makers-upv/maker-xmas-tree/wled/README.md

<!-- FLASH WLED -->
## Flashing custom WLED firmware

### Prerequisites (Windows)

First you will need to install Python and esptool to flash the custom WLED firmware into the ESP8266
* python
https://www.python.org/downloads/windows/

* esptool
  ```sh
  pip install esptool
  ```
### Installation

1. Execute ```flash_wled.bat``` and the procedure will start

<!-- USAGE EXAMPLES -->
## Changin presets and recompiling littlefs image

TODO
