makers-upv/maker-xmas-tree/presentation/Taller Introducción Soldadura.pdf

# Taller

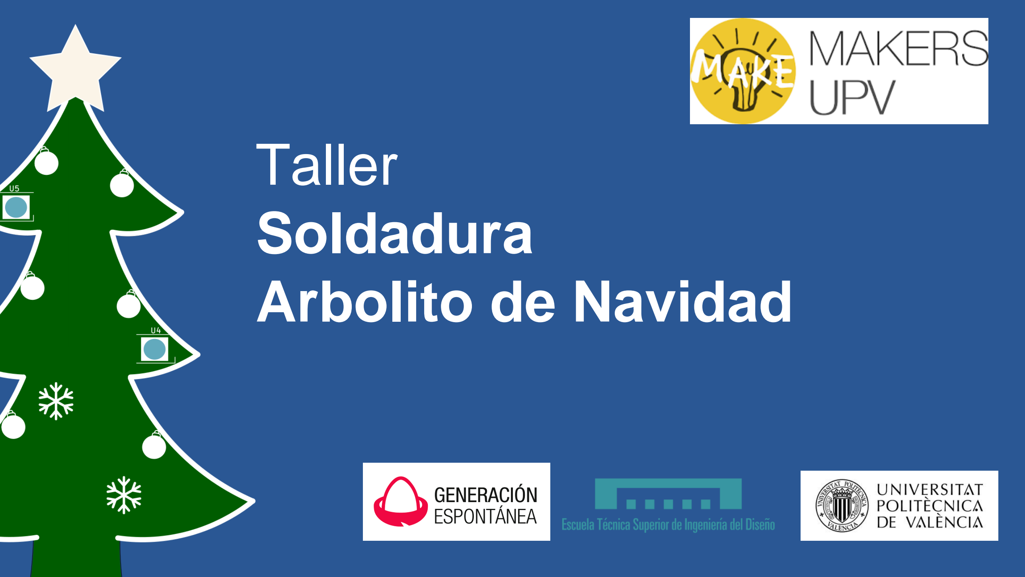
[picture p1: page 1]

# Soldadura Arbolito de Navidad

Taller
Soldadura Arbolito de Navidad

### Agenda

1. ¿Qué es una PCB?
2. Tipos de componentes
3. ¿Qué es soldar?
4. Cómo soldar
5. Soldadura SMD
6. Formas de soldar

Soldadura Arbolito de Navidad

### ¿Qué es una PCB?

PCB ("printed circuit board" en inglés) o placa de circuito impreso en español. Es básicamente es un soporte físico en donde se instalan componentes electrónicos y eléctricos y se interconectan entre ellos.

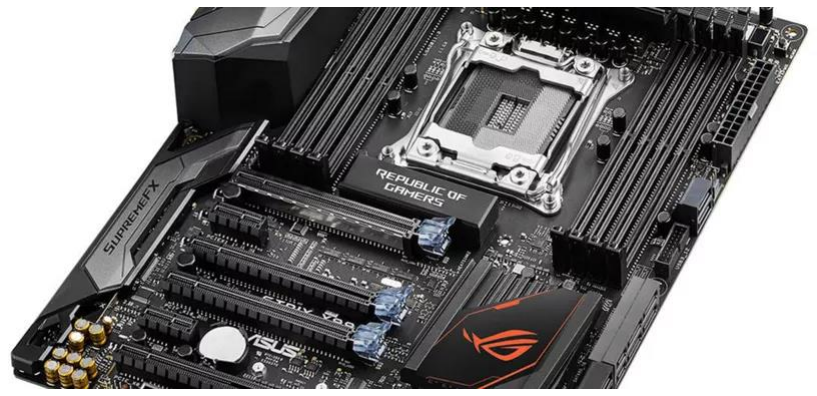
[picture p2: figure]
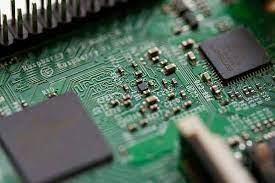
[picture p3: figure]

### Tipos de componentes

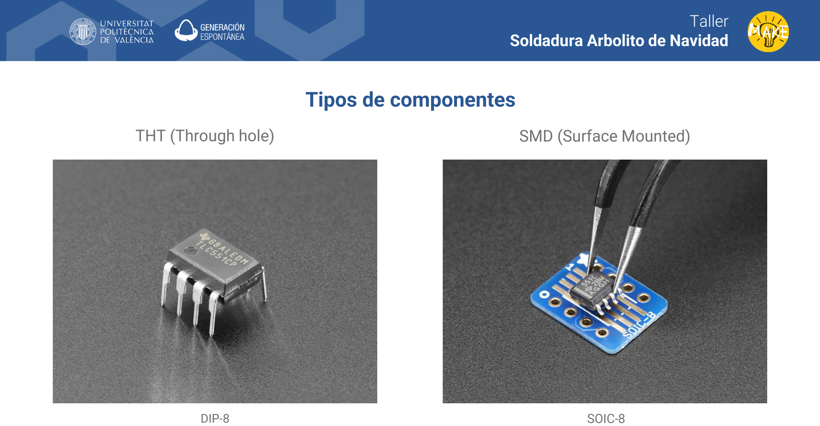
[picture p4: page 4]

Soldadura Arbolito de Navidad

THT (Through hole) | SMD (Surface Mounted)
DIP-8 | SOIC-8

### Tipos de componentes

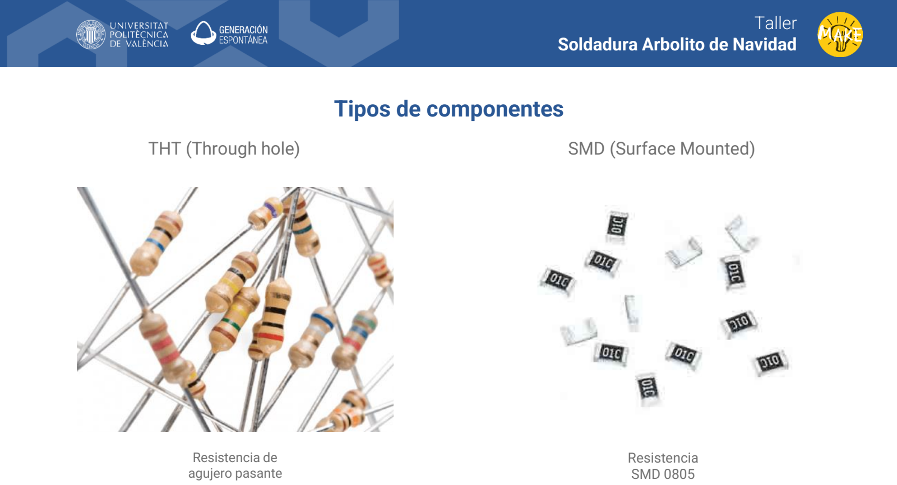
[picture p5: page 5]

Soldadura Arbolito de Navidad

THT (Through hole) | SMD (Surface Mounted)

Resistencia de
agujero pasante

Resistencia
SMD 0805

### Resistencias vs condensadores SMD

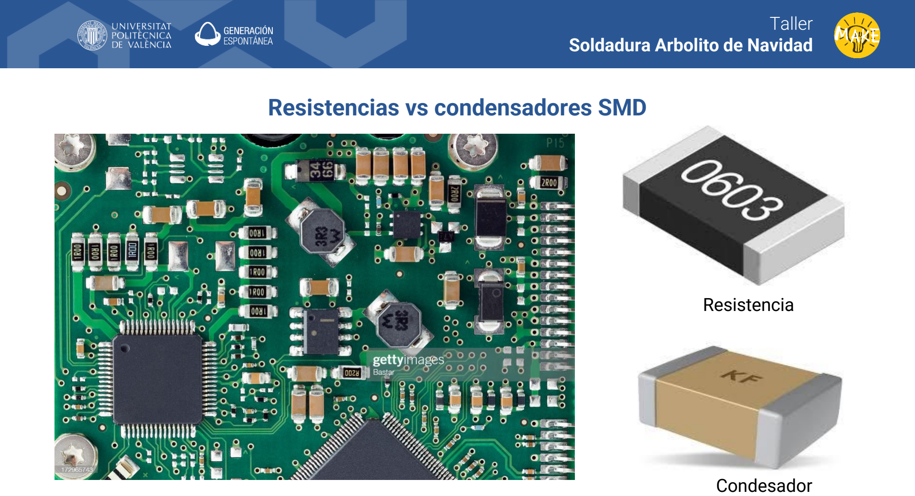
[picture p6: page 6]

Soldadura Arbolito de Navidad

Condesador

Resistencia

Soldadura Arbolito de Navidad

### Encapsulados típicos

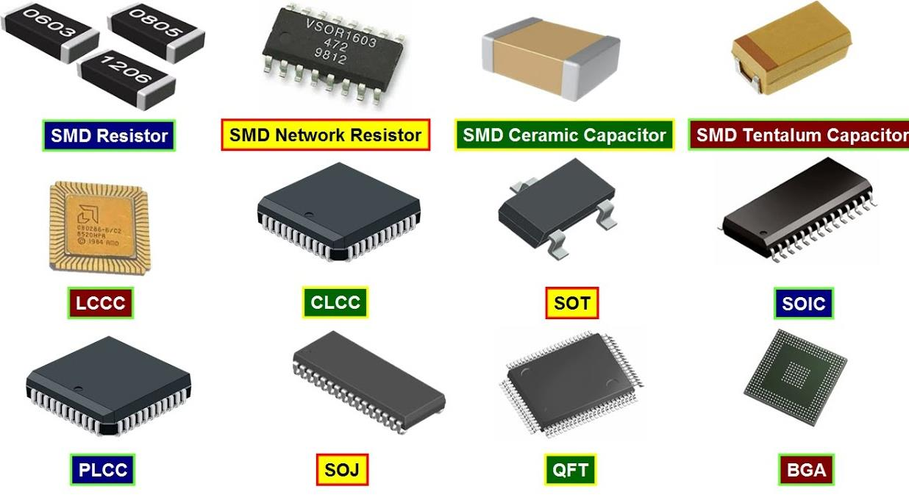
[picture p7: figure]

Soldadura Arbolito de Navidad

### ¿Que es soldar?

Consiste en unir los componentes tanto de forma electrica como mecánica usando un metal con temperatura de fusión baja (180 a 260)ºC. Normalemente (aka siempre) estaño.

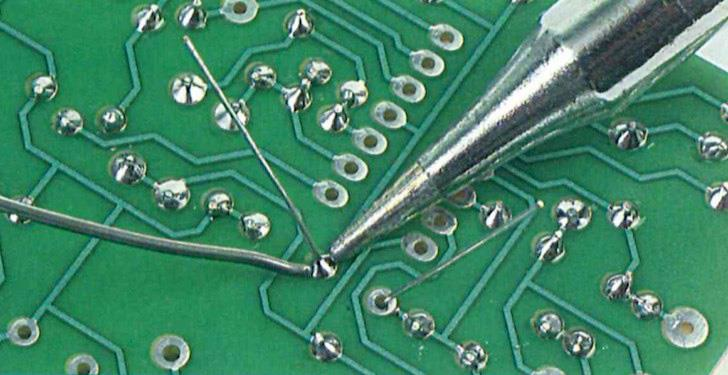
[picture p8: figure]

### Tipos de estaño

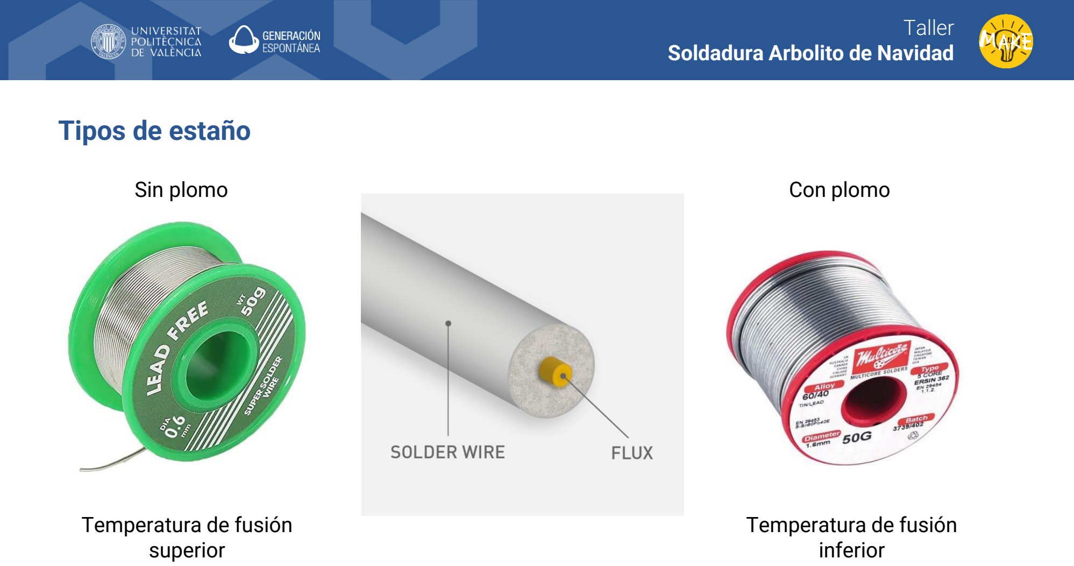
[picture p9: page 9]

Soldadura Arbolito de Navidad

Sin plomo | Con plomo

Temperatura de fusión
superior

Temperatura de fusión
inferior

Soldadura Arbolito de Navidad

### Flux

El flux es un fundente que elimina las películas de óxido que se forman en la superficie de los metales que se están soldando. Además hace que el esaño fluya de manera más uniforme sobre las superficies sin formar bolas.
Existe en formato líquido, formato pasta, formato boli…

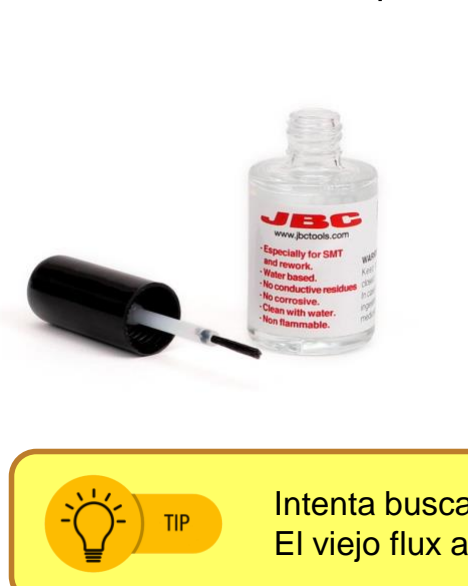
[picture p10: figure]
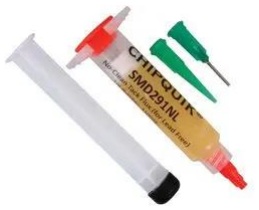
[picture p11: figure]

Intenta buscar “No-clean Flux”

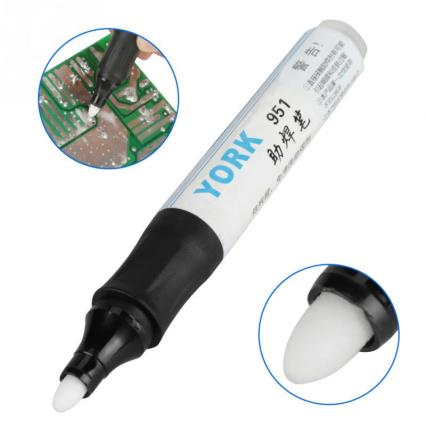
[picture p12: figure]

El viejo flux a base de resina de colofonia es muy sucio y tóxico. No usar flux de fontanero!

Soldadura Arbolito de Navidad

### Soldador formato lapiz

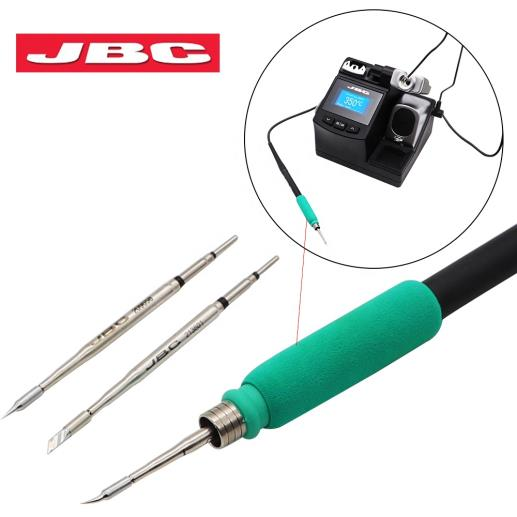
[picture p13: figure]
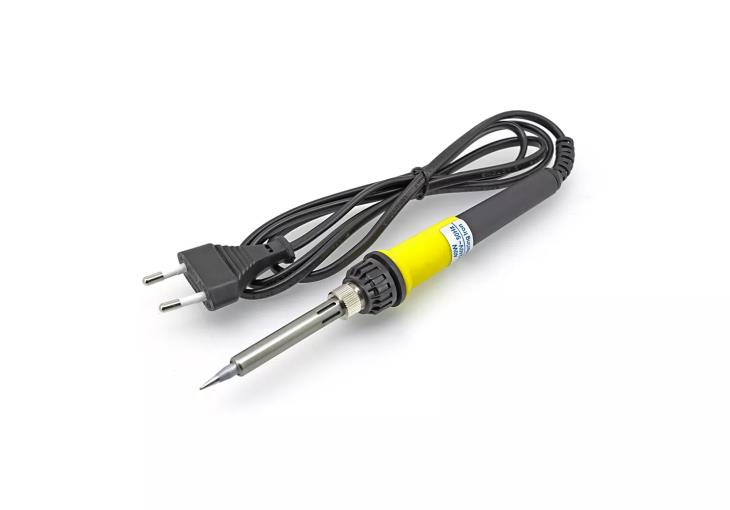
[picture p14: figure]

Un buen soldador no es un gasto, es una inversión!
Es como un cuchillo a un chef, merece la pena gastarse un poco más. Se nota!!

Hay dos tipos, los de teconología antigua (de cartucho) y los modernos que permiten cambiar las puntas en caliente.

### Soldadura THT/PTH

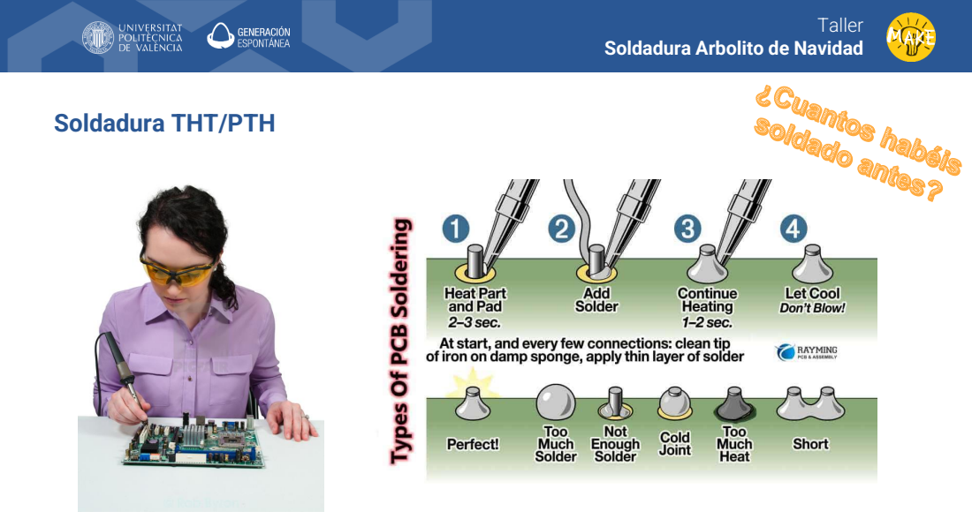
[picture p15: page 12]

Soldadura Arbolito de Navidad

### La soldadura perfecta

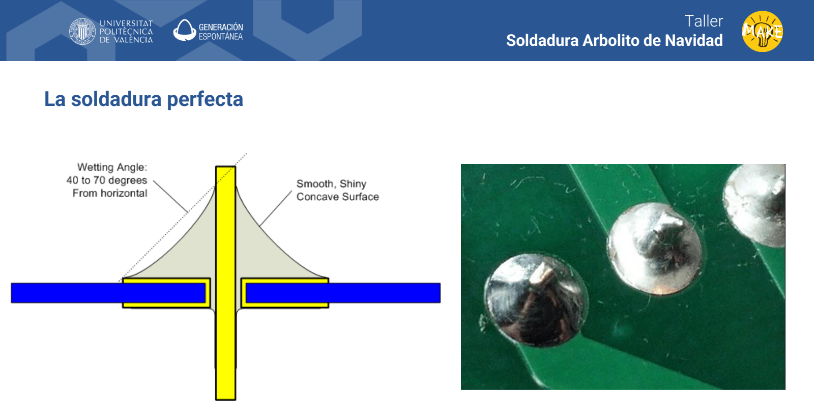
[picture p16: page 13]

Soldadura Arbolito de Navidad

Soldadura Arbolito de Navidad

### Ejemplos no tan buenos … I

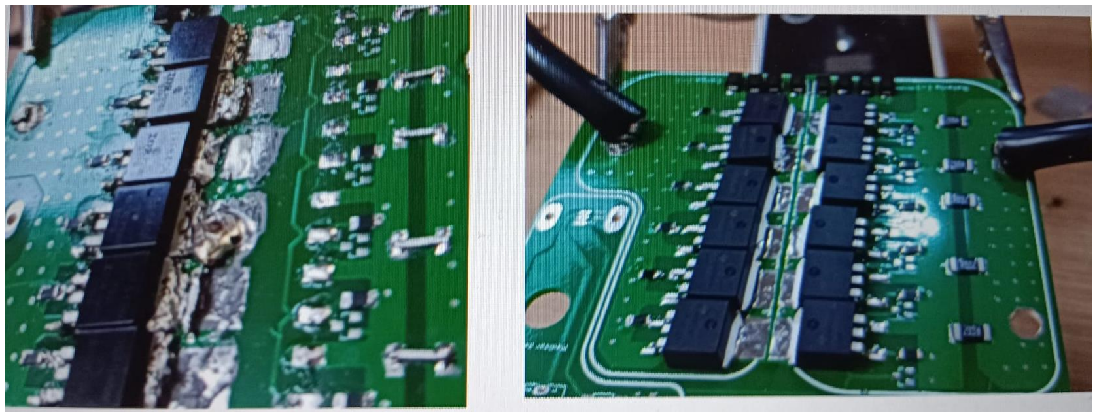
[picture p17: figure]

No pasa nada si al prinicipio sueldas como el de la izquierda. La práctica hace al maestro.

Soldadura Arbolito de Navidad

### Ejemplos II

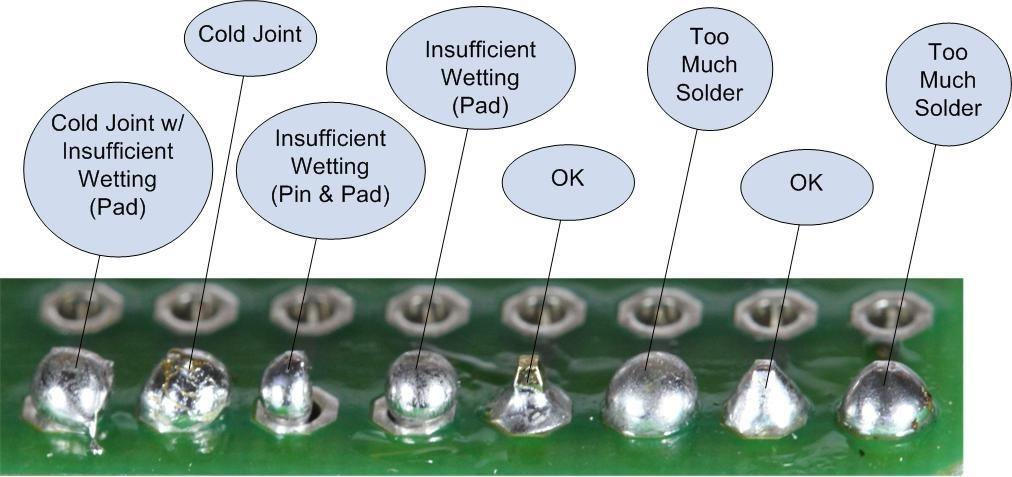
[picture p18: figure]

Puedes usar flux para mejorar la soldadura. Pero no te emociones... ☺

### Soldadura SMD

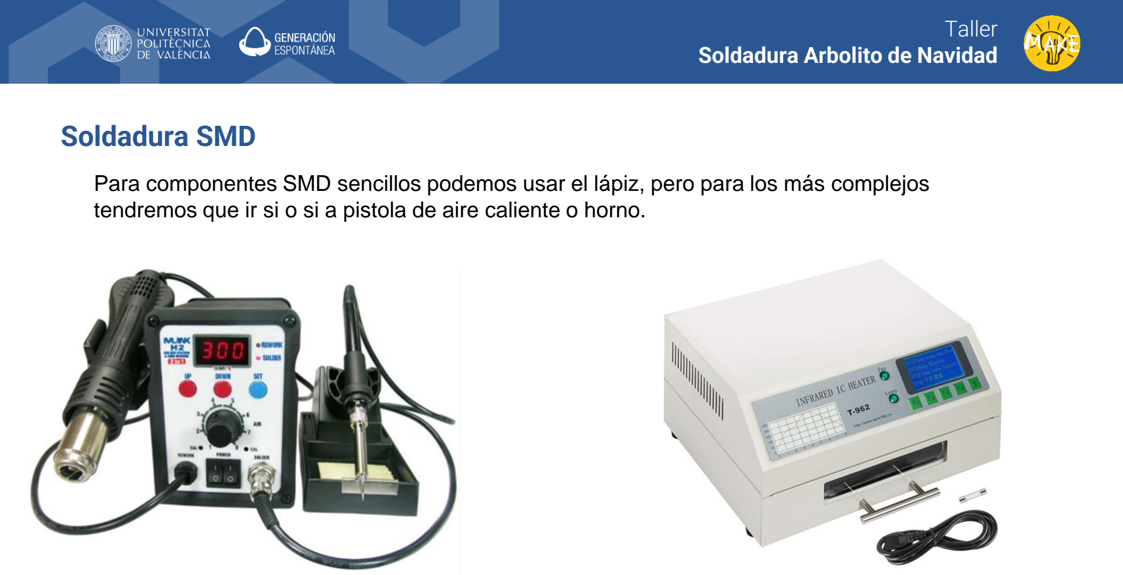
[picture p19: page 16]

Soldadura Arbolito de Navidad

Para componentes SMD sencillos podemos usar el lápiz, pero para los más complejos tendremos que ir si o si a pistola de aire caliente o horno.

### Resistencias y condensadores SMD

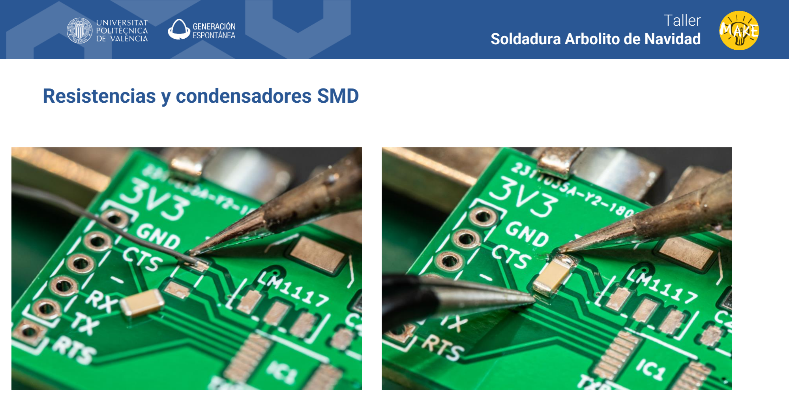
[picture p20: page 17]

Soldadura Arbolito de Navidad

### Estaño en pasta

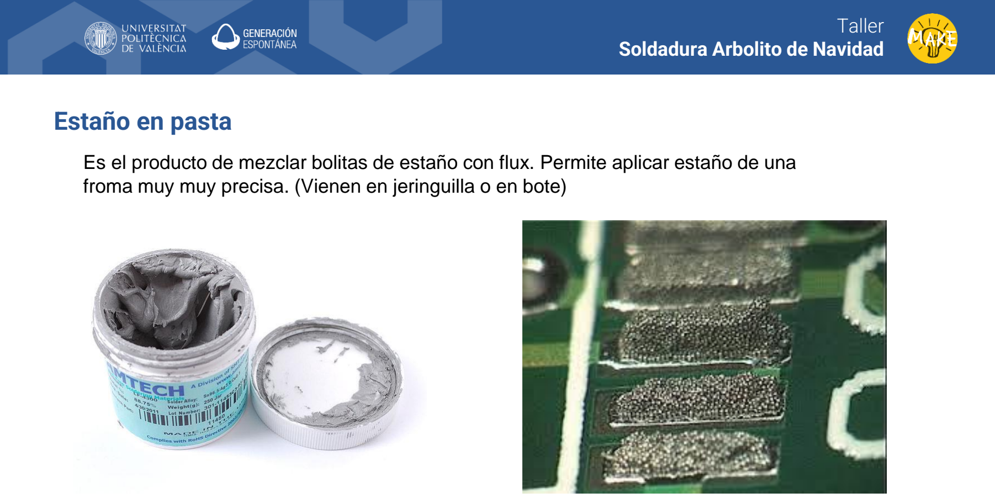
[picture p21: page 18]

Soldadura Arbolito de Navidad

Es el producto de mezclar bolitas de estaño con flux. Permite aplicar estaño de una froma muy muy precisa. (Vienen en jeringuilla o en bote)

### Stencil

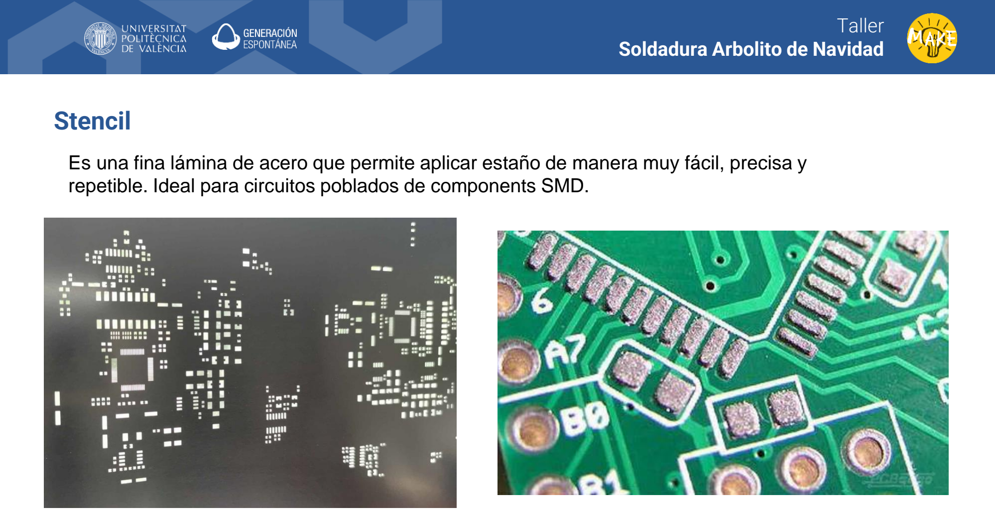
[picture p22: page 19]

Soldadura Arbolito de Navidad

Es una fina lámina de acero que permite aplicar estaño de manera muy fácil, precisa y repetible. Ideal para circuitos poblados de components SMD.

Soldadura Arbolito de Navidad

### Poner pasta con stencil

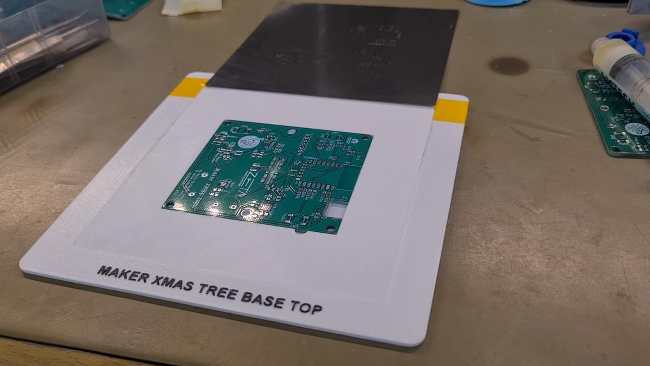
[picture p23: figure]

Soldadura Arbolito de Navidad

### Posicionar componentes

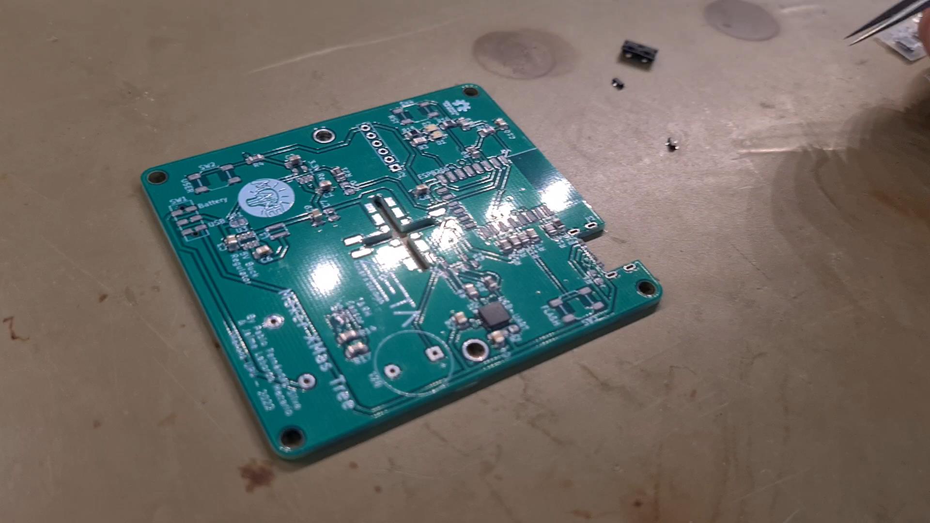
[picture p24: figure]

Soldadura Arbolito de Navidad

### ¿Como sabemos donde va cada cosa?

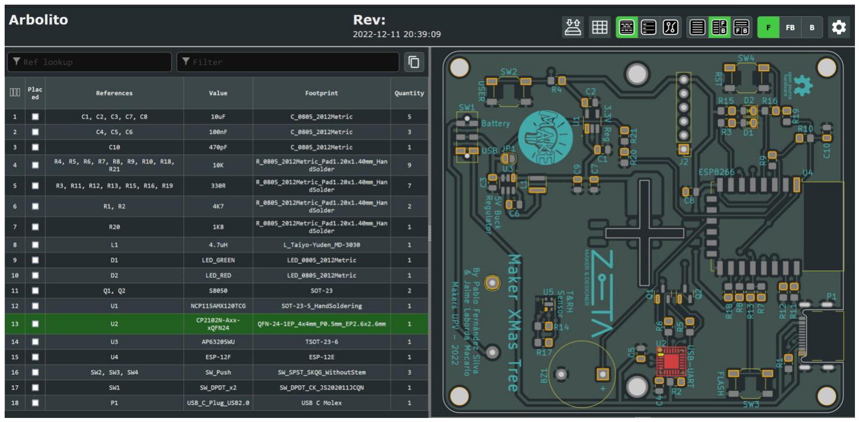
[picture p25: figure]

makers-upv.github.io/maker-xmas-tree

Soldadura Arbolito de Navidad

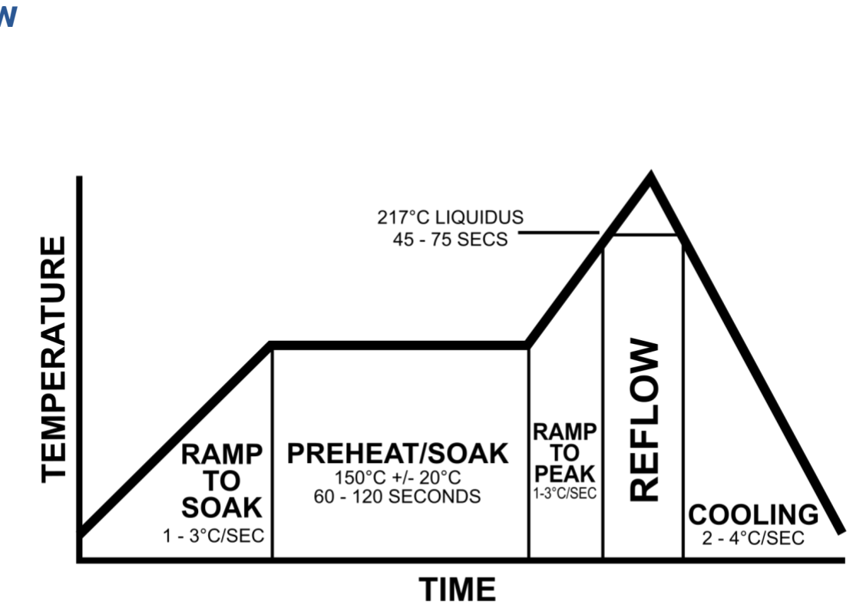
[picture p26: figure]

### Horno reflow

### Soldar portabaterías

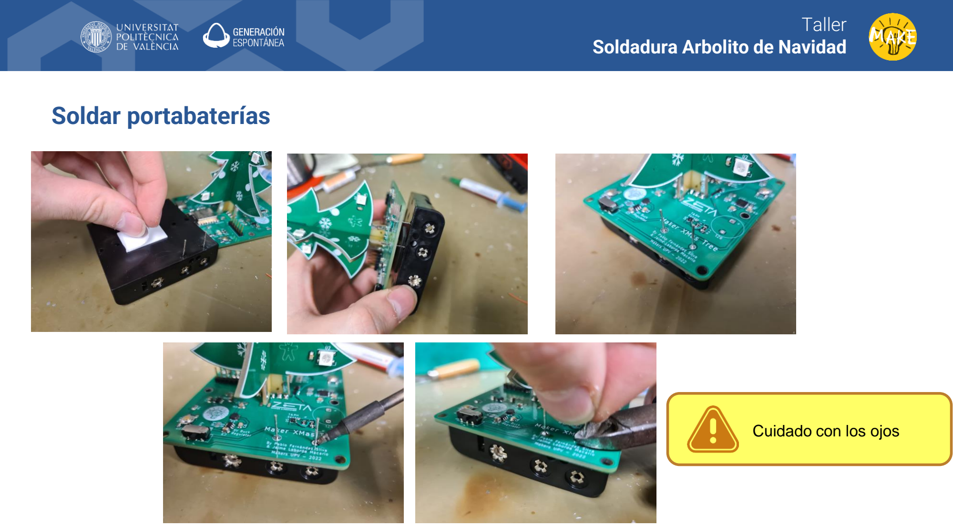
[picture p27: page 24]

Soldadura Arbolito de Navidad

Cuidado con los ojos

Manos a la obra..

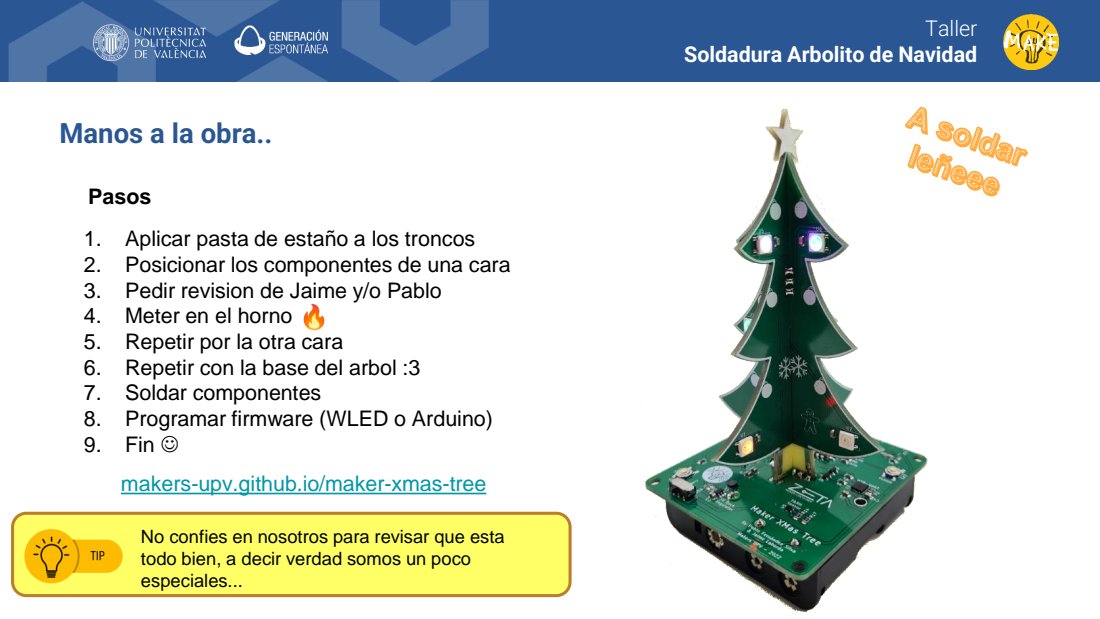
[picture p28: page 25]
Pasos

Soldadura Arbolito de Navidad

1. Aplicar pasta de estaño a los troncos
2. Posicionar los componentes de una cara
3. Pedir revision de Jaime y/o Pablo
4. Meter en el horno
5. Repetir por la otra cara
6. Repetir con la base del arbol :3
7. Soldar componentes
8. Programar firmware (WLED o Arduino)
9. Fin ☺

makers-upv.github.io/maker-xmas-tree

No confies en nosotros para revisar que esta
todo bien, a decir verdad somos un poco
especiales...

Soldadura Arbolito de Navidad

# Instalar firmware WLED

### Instalar firmware WLED

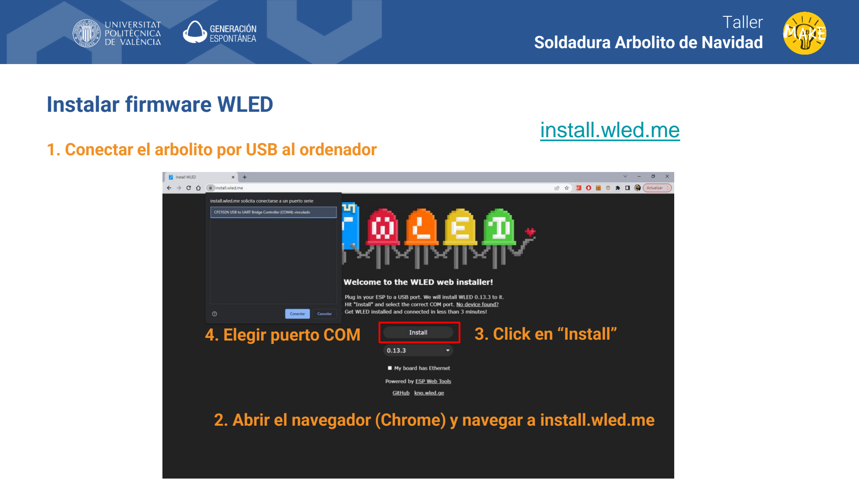
[picture p29: page 27]

Soldadura Arbolito de Navidad

### 1. Conectar el arbolito por USB al ordenador

### 2. Abrir el navegador (Chrome) y navegar a install.wled.me

4. Elegir puerto COM | 3. Click en “Install”

### install.wled.me

Soldadura Arbolito de Navidad

### Instalar firmware WLED

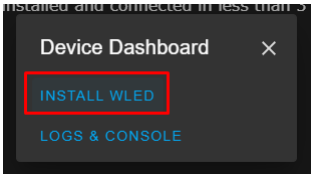
[picture p30: figure]
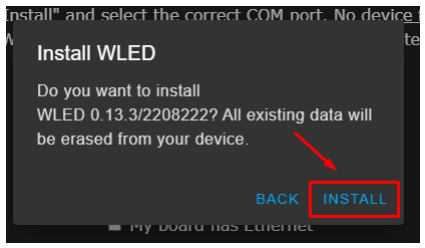
[picture p31: figure]

5. Click en “Install WLED” | 6. Click en “Install”

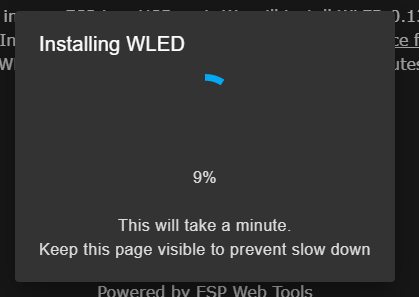
[picture p32: figure]

Instalando…

Soldadura Arbolito de Navidad

### Instalar firmware WLED

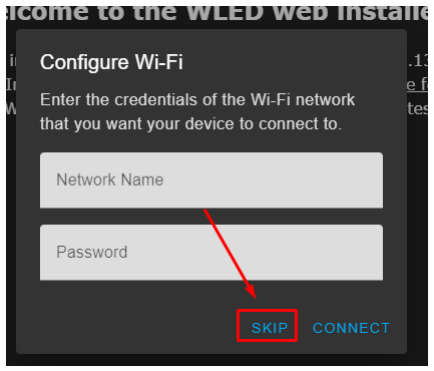
[picture p33: figure]
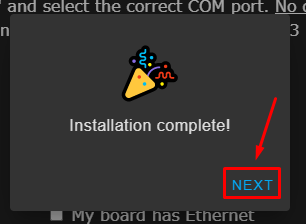
[picture p34: figure]

7. Click en “Skip” | 8. Click en Next

### Configurar WLED desde el móvil (o PC)

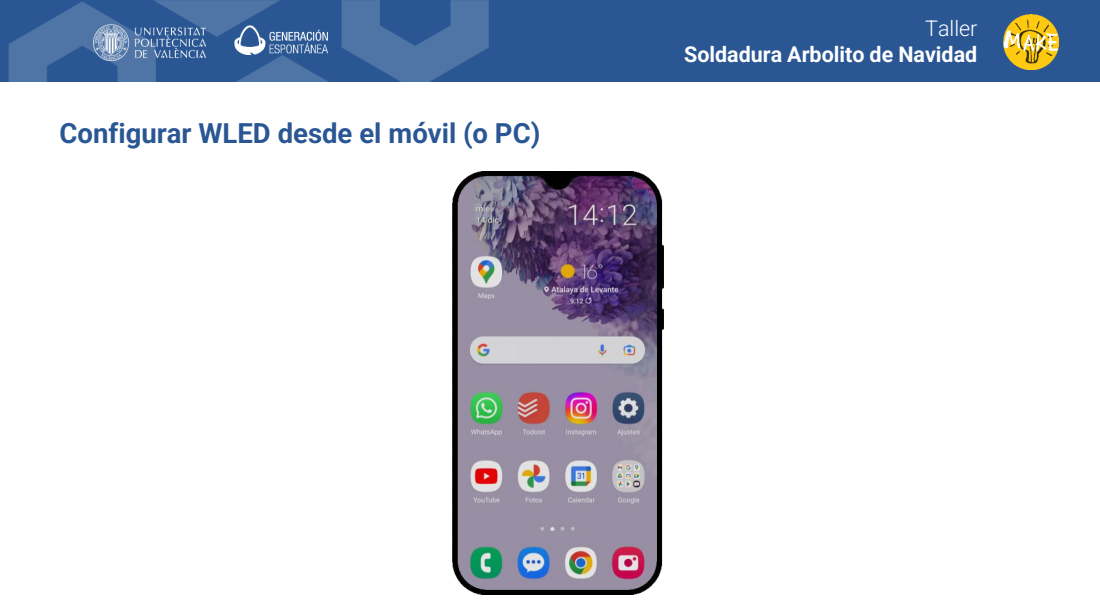
[picture p35: page 30]

Soldadura Arbolito de Navidad

Soldadura Arbolito de Navidad

### Modificar los colores con WLED

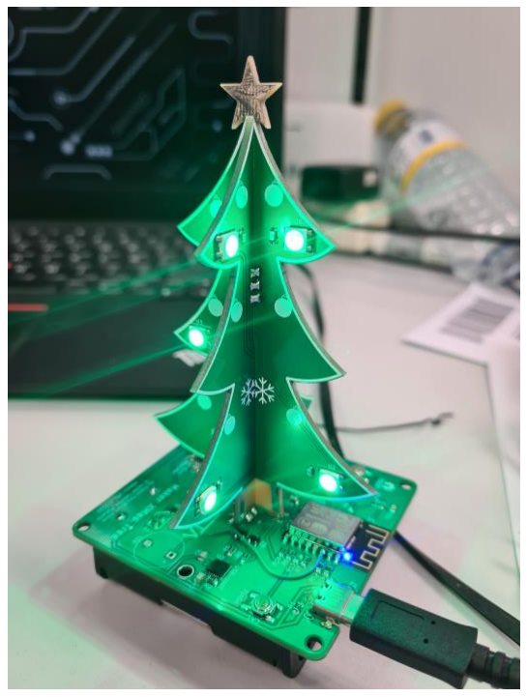
[picture p36: figure]
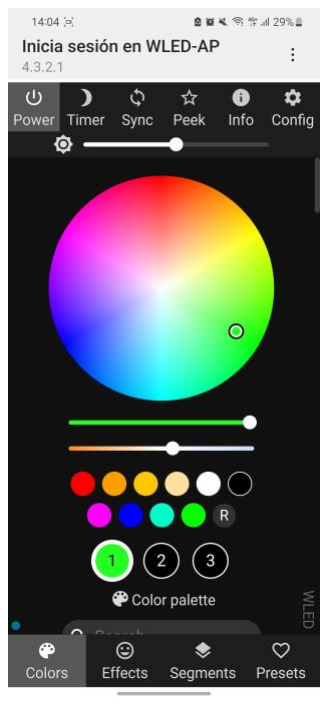
[picture p37: figure]

Soldadura Arbolito de Navidad

# Firmware Arduino Neopixel

Soldadura Arbolito de Navidad

### 1. Instalar Arduino IDE (www.arduino.cc/en/software)

### Firmware Arduino Neopixel

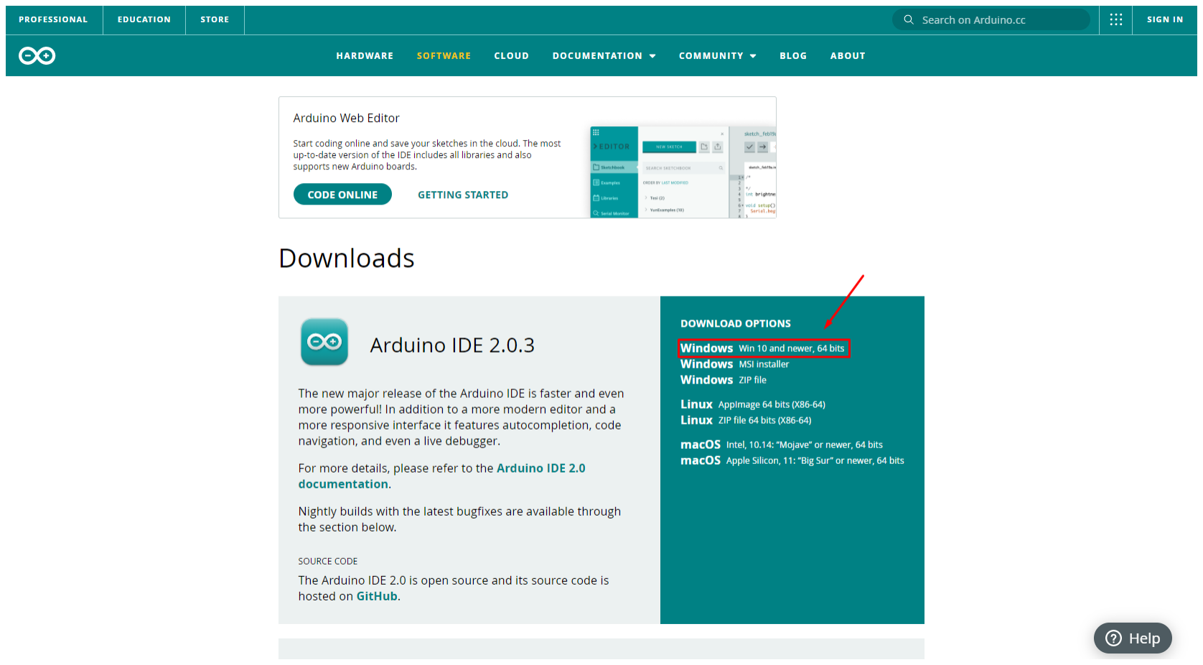
[picture p38: figure]

### Firmware Arduino Neopixel

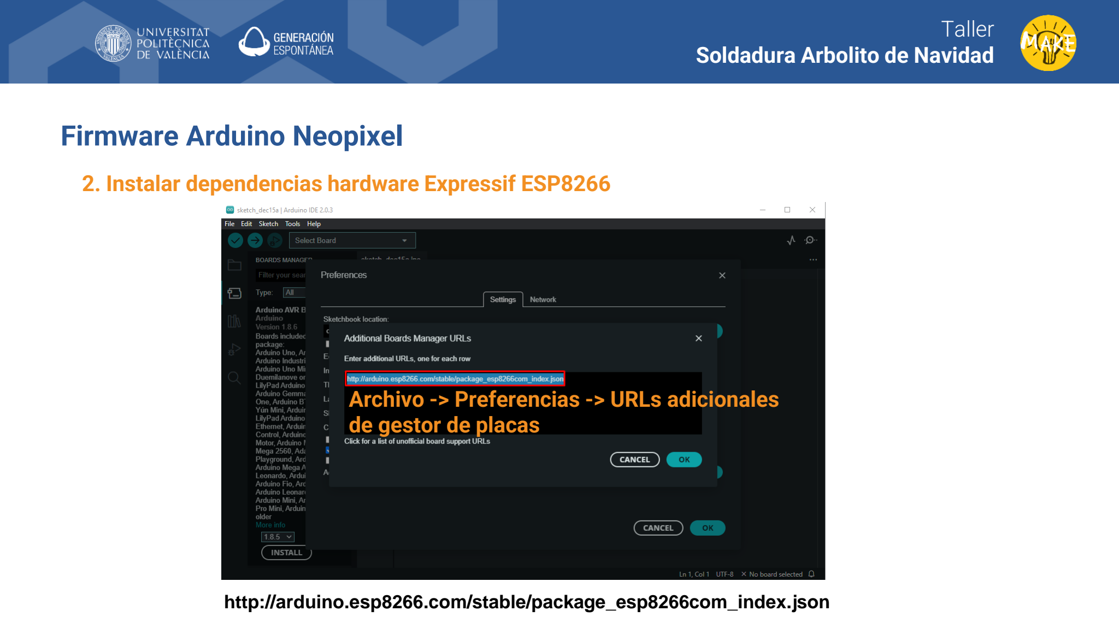
[picture p39: page 34]

Soldadura Arbolito de Navidad

### 2. Instalar dependencias hardware Expressif ESP8266

http://arduino.esp8266.com/stable/package_esp8266com_index.json

Archivo -> Preferencias -> URLs adicionales de gestor de placas

### Firmware Arduino Neopixel

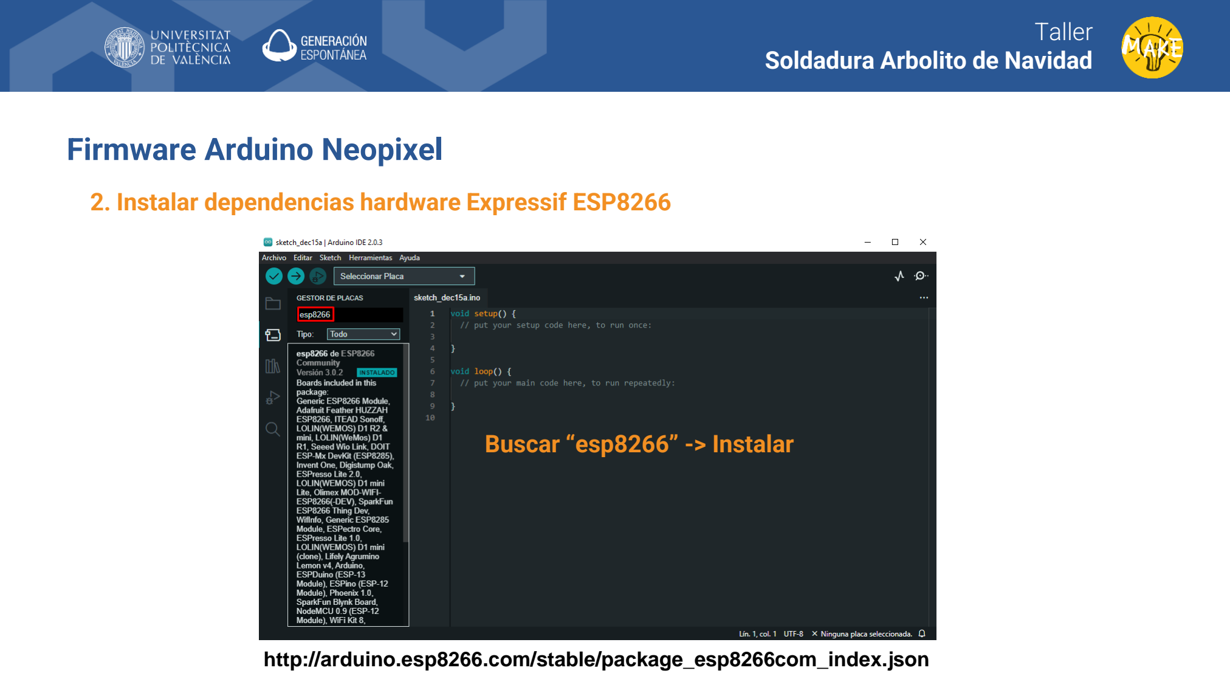
[picture p40: page 35]

Soldadura Arbolito de Navidad

Buscar “esp8266” -> Instalar

### 2. Instalar dependencias hardware Expressif ESP8266

http://arduino.esp8266.com/stable/package_esp8266com_index.json

### Firmware Arduino Neopixel

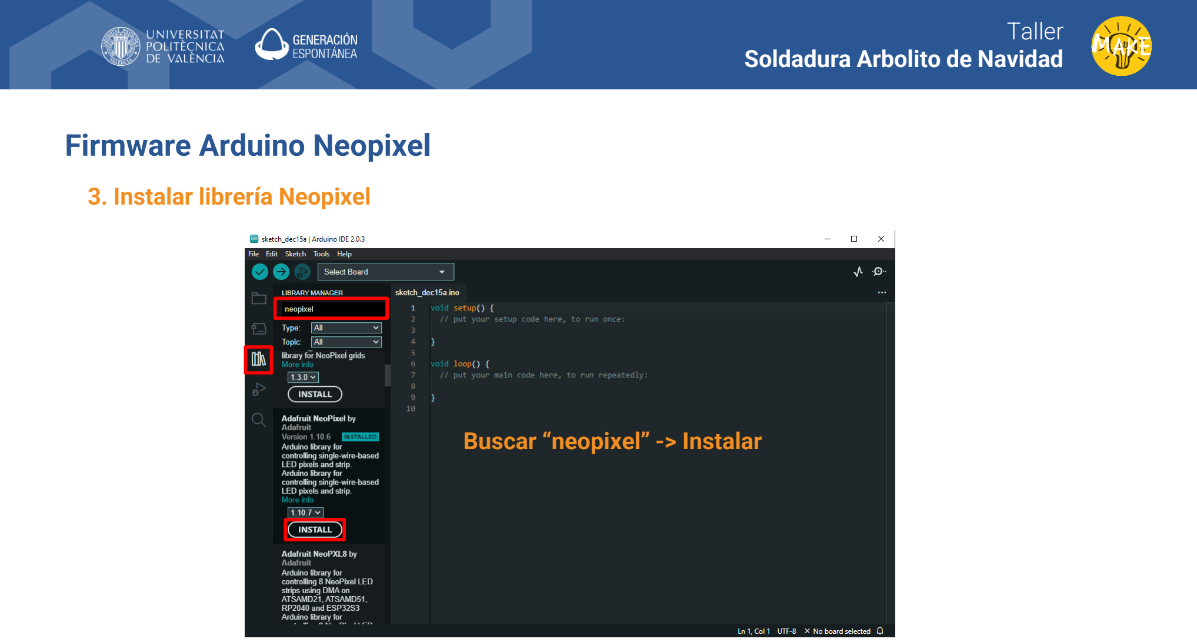
[picture p41: page 36]

Soldadura Arbolito de Navidad

### 3. Instalar librería Neopixel

Buscar “neopixel” -> Instalar

### Firmware Arduino Neopixel

Soldadura Arbolito de Navidad

### 3. Instalar librería Neopixel

Buscar “neopixel” -> Instalar

Soldadura Arbolito de Navidad

### Firmware Arduino Neopixel

### 4. Seleccionar la placa y el puerto COM (Buscar “nodemcu”)

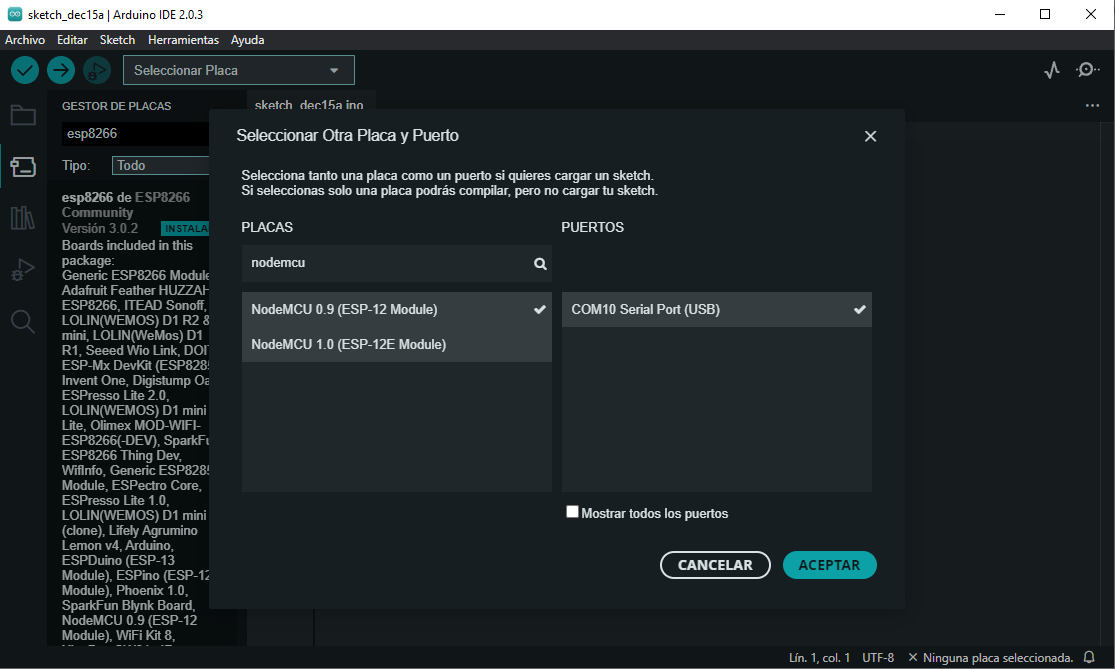
[picture p42: figure]

Soldadura Arbolito de Navidad

### Firmware Arduino Neopixel

### 5. Cargar el ejemplo “Strandtest”

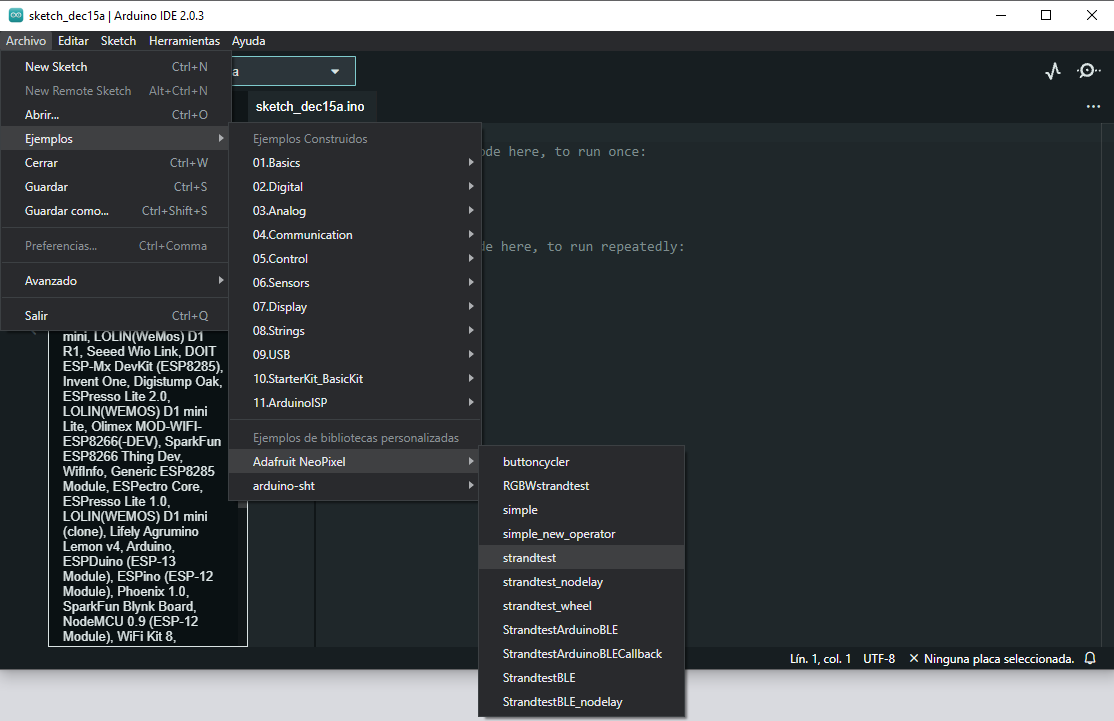
[picture p43: figure]

Soldadura Arbolito de Navidad

### Firmware Arduino Neopixel

### 6. Modificar LED_PIN y LED_COUNT a 12

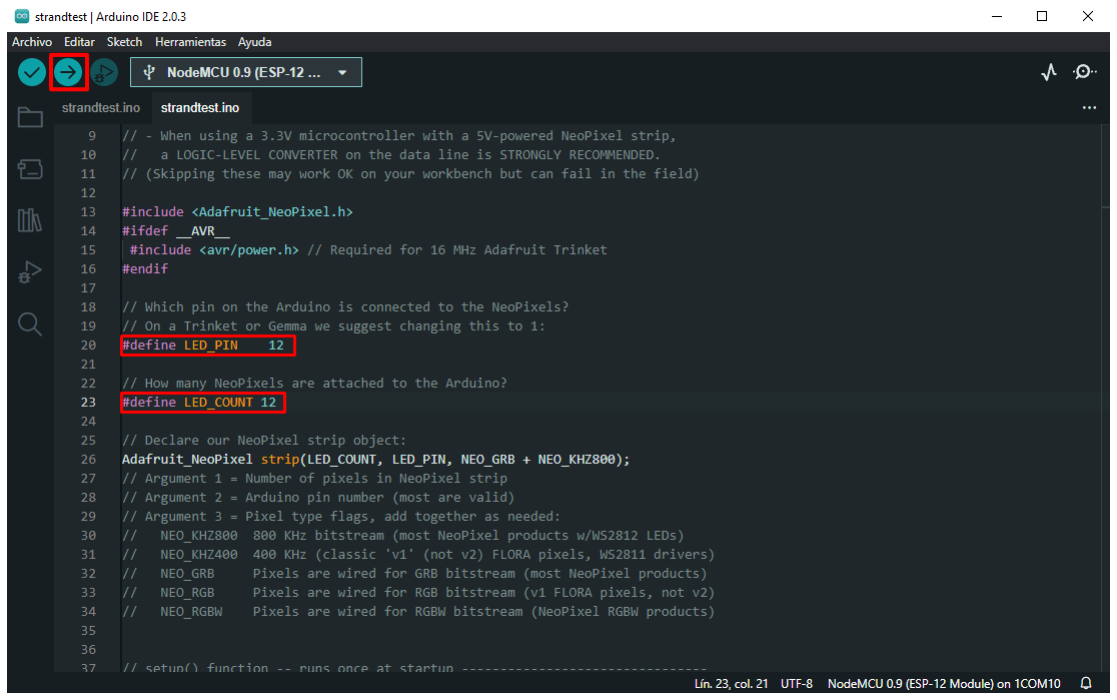
[picture p44: figure]
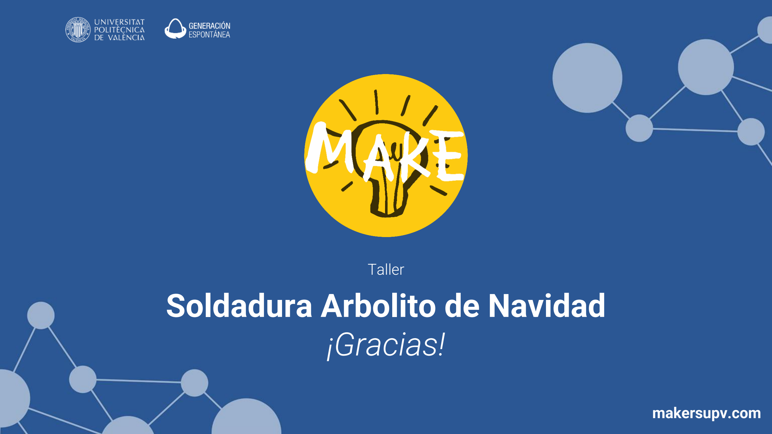
[picture p45: page 41]

Soldadura Arbolito de Navidad

Taller

# Soldadura Arbolito de Navidad ¡Gracias!

makersupv.com
