makers-upv/maker-xmas-tree/pcb/3d/Arbolito Tronco 1.step

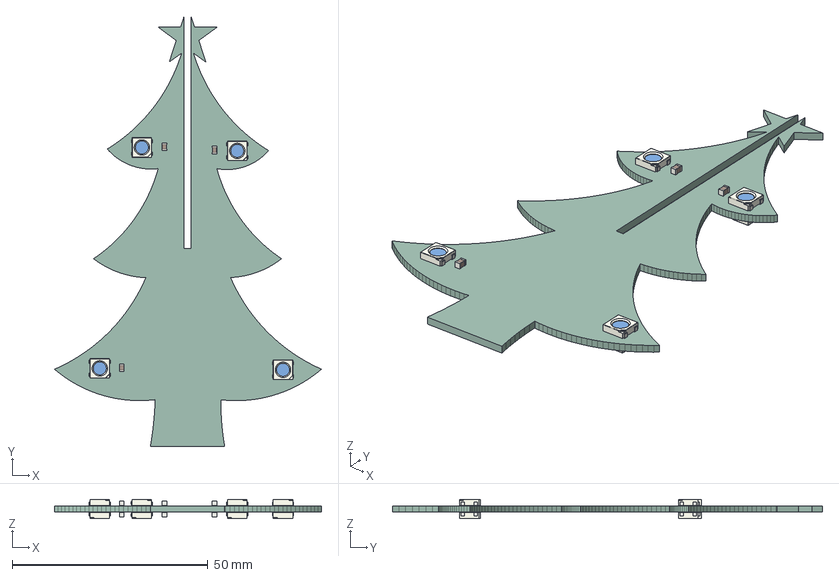
[picture p46: CAD file, 2023-12-17]
pcb/3d/Arbolito Tronco 1.step
68.2 x 109.9 x 4.90 mm
PCB
