makers-upv/maker-xmas-tree/pcb/kicad/Base/Arbolito.dxf

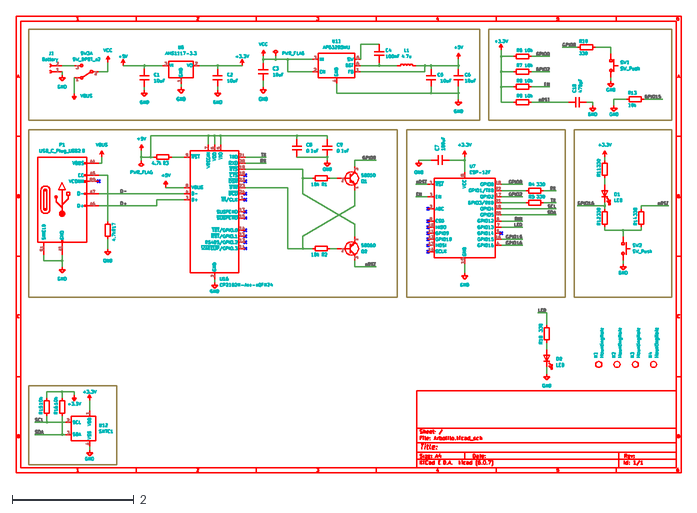
[picture p47: CAD file, 2023-12-17]
pcb/kicad/Base/Arbolito.dxf
10.9 x 7.48
