makers-upv/maker-xmas-tree/tools/Join tool/Maker XMas Tree Joint Tool.STEP

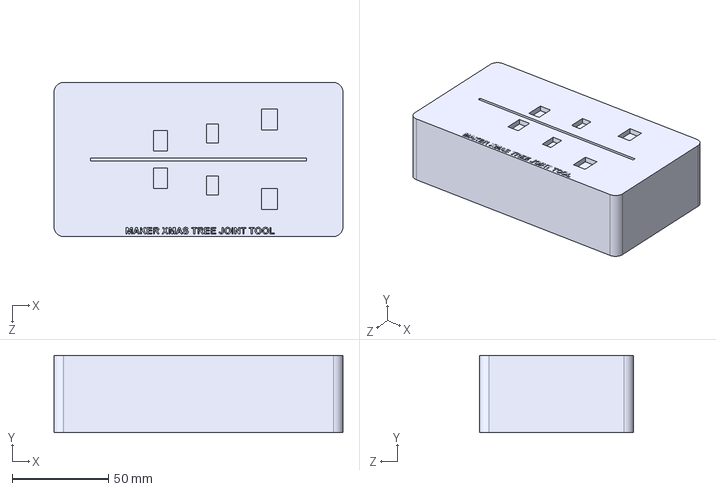
[picture p48: CAD file, 2023-12-17]
tools/Join tool/Maker XMas Tree Joint Tool.STEP
150.0 x 40.2 x 80.0 mm
