makers-upv/maker-xmas-tree/tools/Stencil tool/Stencil tool Maker XMas Tree Arbol rev2.SLDPRT

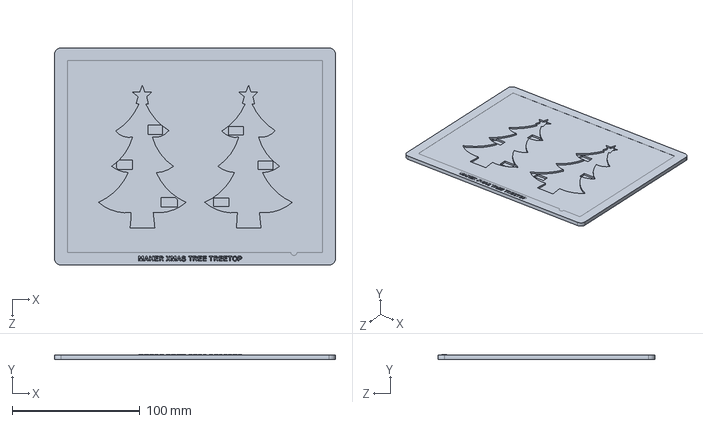
[picture p49: CAD file, 2023-12-17]
tools/Stencil tool/Stencil tool Maker XMas Tree Arbol rev2.SLDPRT
220.0 x 4.15 x 170.0 mm
