makers-upv/maker-xmas-tree/pcb/3d/Arbolito Tronco 2.step

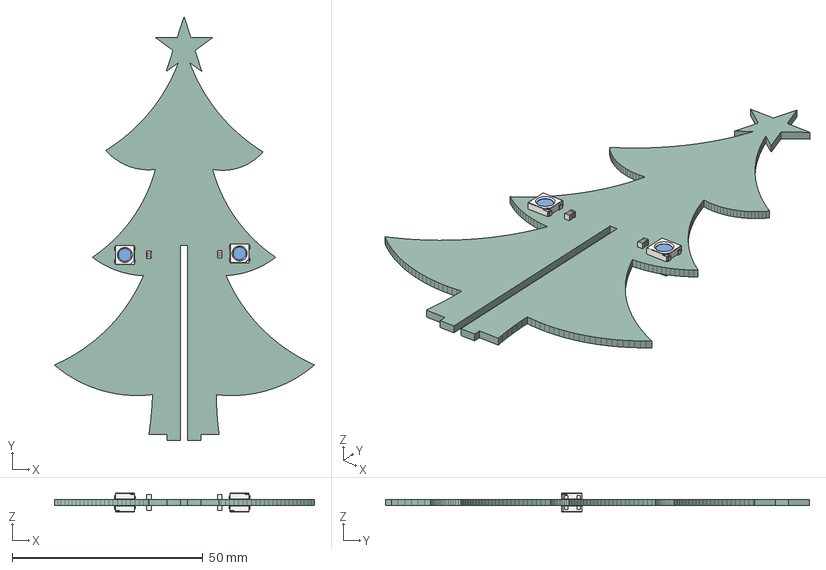
[picture p50: CAD file, 2023-12-17]
pcb/3d/Arbolito Tronco 2.step
68.2 x 111.0 x 4.90 mm
PCB
