makers-upv/maker-xmas-tree/pcb/3d/Arbolito.step

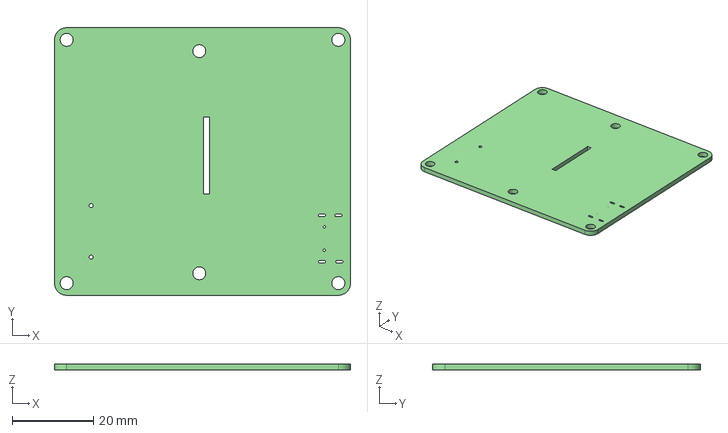
[picture p51: CAD file, 2023-12-17]
pcb/3d/Arbolito.step
73.0 x 66.0 x 1.60 mm
