makers-upv/maker-xmas-tree/tools/Stencil tool/Stencil tool Maker XMas Tree Base v2.SLDPRT

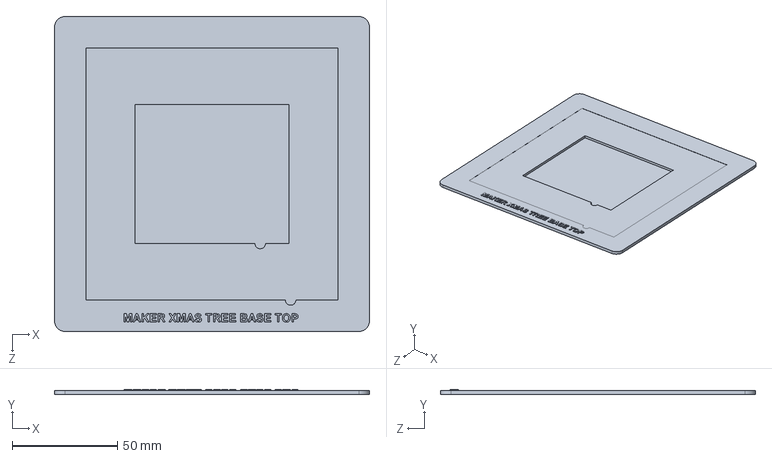
[picture p52: CAD file, 2023-12-17]
tools/Stencil tool/Stencil tool Maker XMas Tree Base v2.SLDPRT
150.0 x 2.35 x 150.0 mm
