makers-upv/maker-xmas-tree/(list of files, cad)

Other CAD files:
tools/Stencil tool/Stencil tool Maker XMas Tree Arbol rev3.STL
tools/Join tool/Maker XMas Tree Joint Tool.SLDPRT
tools/Join tool/Maker XMas Tree Joint Tool.STL
tools/Stencil tool/Stencil tool Maker XMas Tree Base v2.STL
