makers-upv/maker-xmas-tree/(threads)

Thread 2 (2023-12-17):

USB UART Programming not working

jaimelaborda, 2023-12-17:
USB UART Programming not working in Rev3 because D+ & D- lines are twisted (differential pairs do have polarity @Pfersil13)

https://electronics.stackexchange.com/questions/73295/in-a-usb-cable-is-it-ok-to-swap-the-d-and-d-wires
