makers-upv/maker-xmas-tree/pcb/sch/MakersXmasTree_Base.pdf

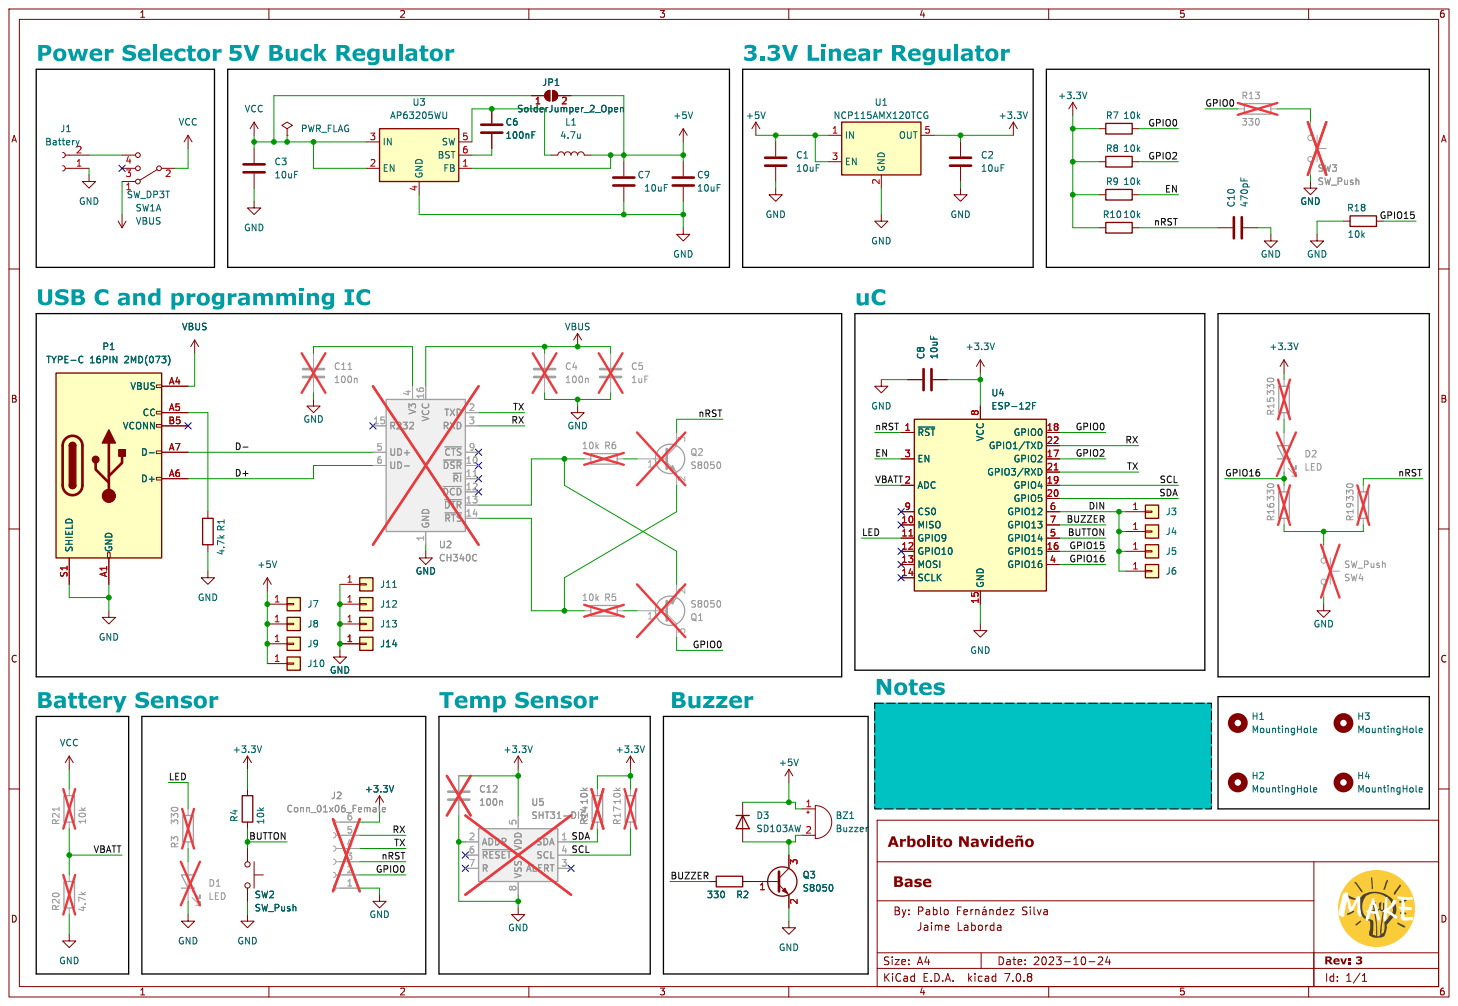
[picture p53: page 1]

4 UD+ 5 UD- 6 ~{CTS}9 P1 TYPE-C 16PIN 2MD(073) GND A1 VBUS A4 CC A5 D+ A6 D- A7 VCONN B5 SHIELD S1 VBUS

1 ~{DSR} 10 ~{RI} 11 ~{DCD} 12 ~{DTR} 13 ~{RTS} 14 R232 15 VCC 16 TXD 2 RXD 3 V3
