makers-upv/maker-xmas-tree/pcb/sch/MakersXmasTree_Top1.pdf

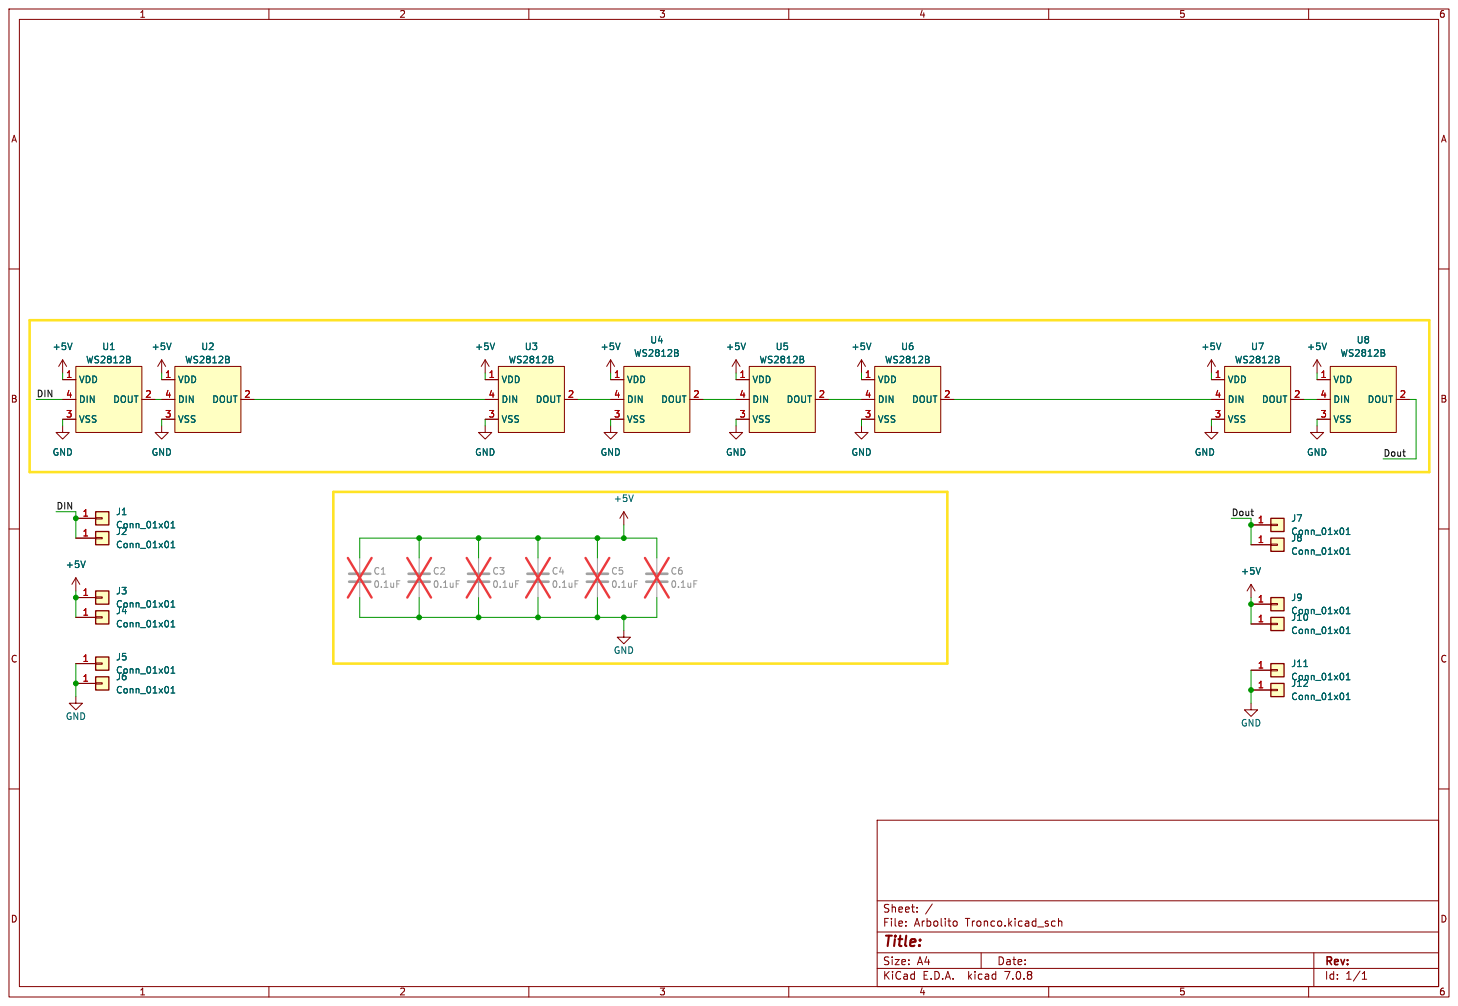
[picture p54: page 1]
