makers-upv/maker-xmas-tree/pcb/sch/MakersXmasTree_Top2.pdf

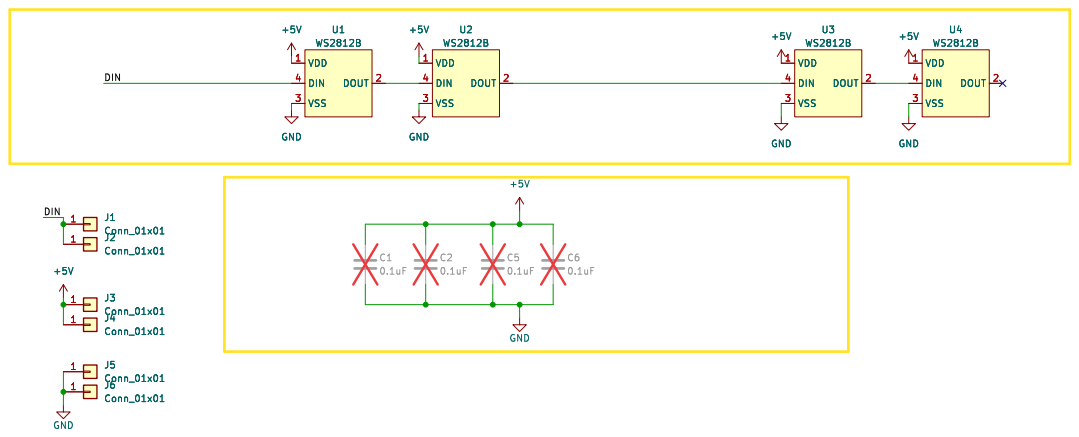
[picture p55: page 1]
