makers-upv/maker-xmas-tree/pcb/kicad/Base/Arbolito.kicad_pcb

## KiCad design pcb/kicad/Base/Arbolito.kicad_pcb (2023-12-20)

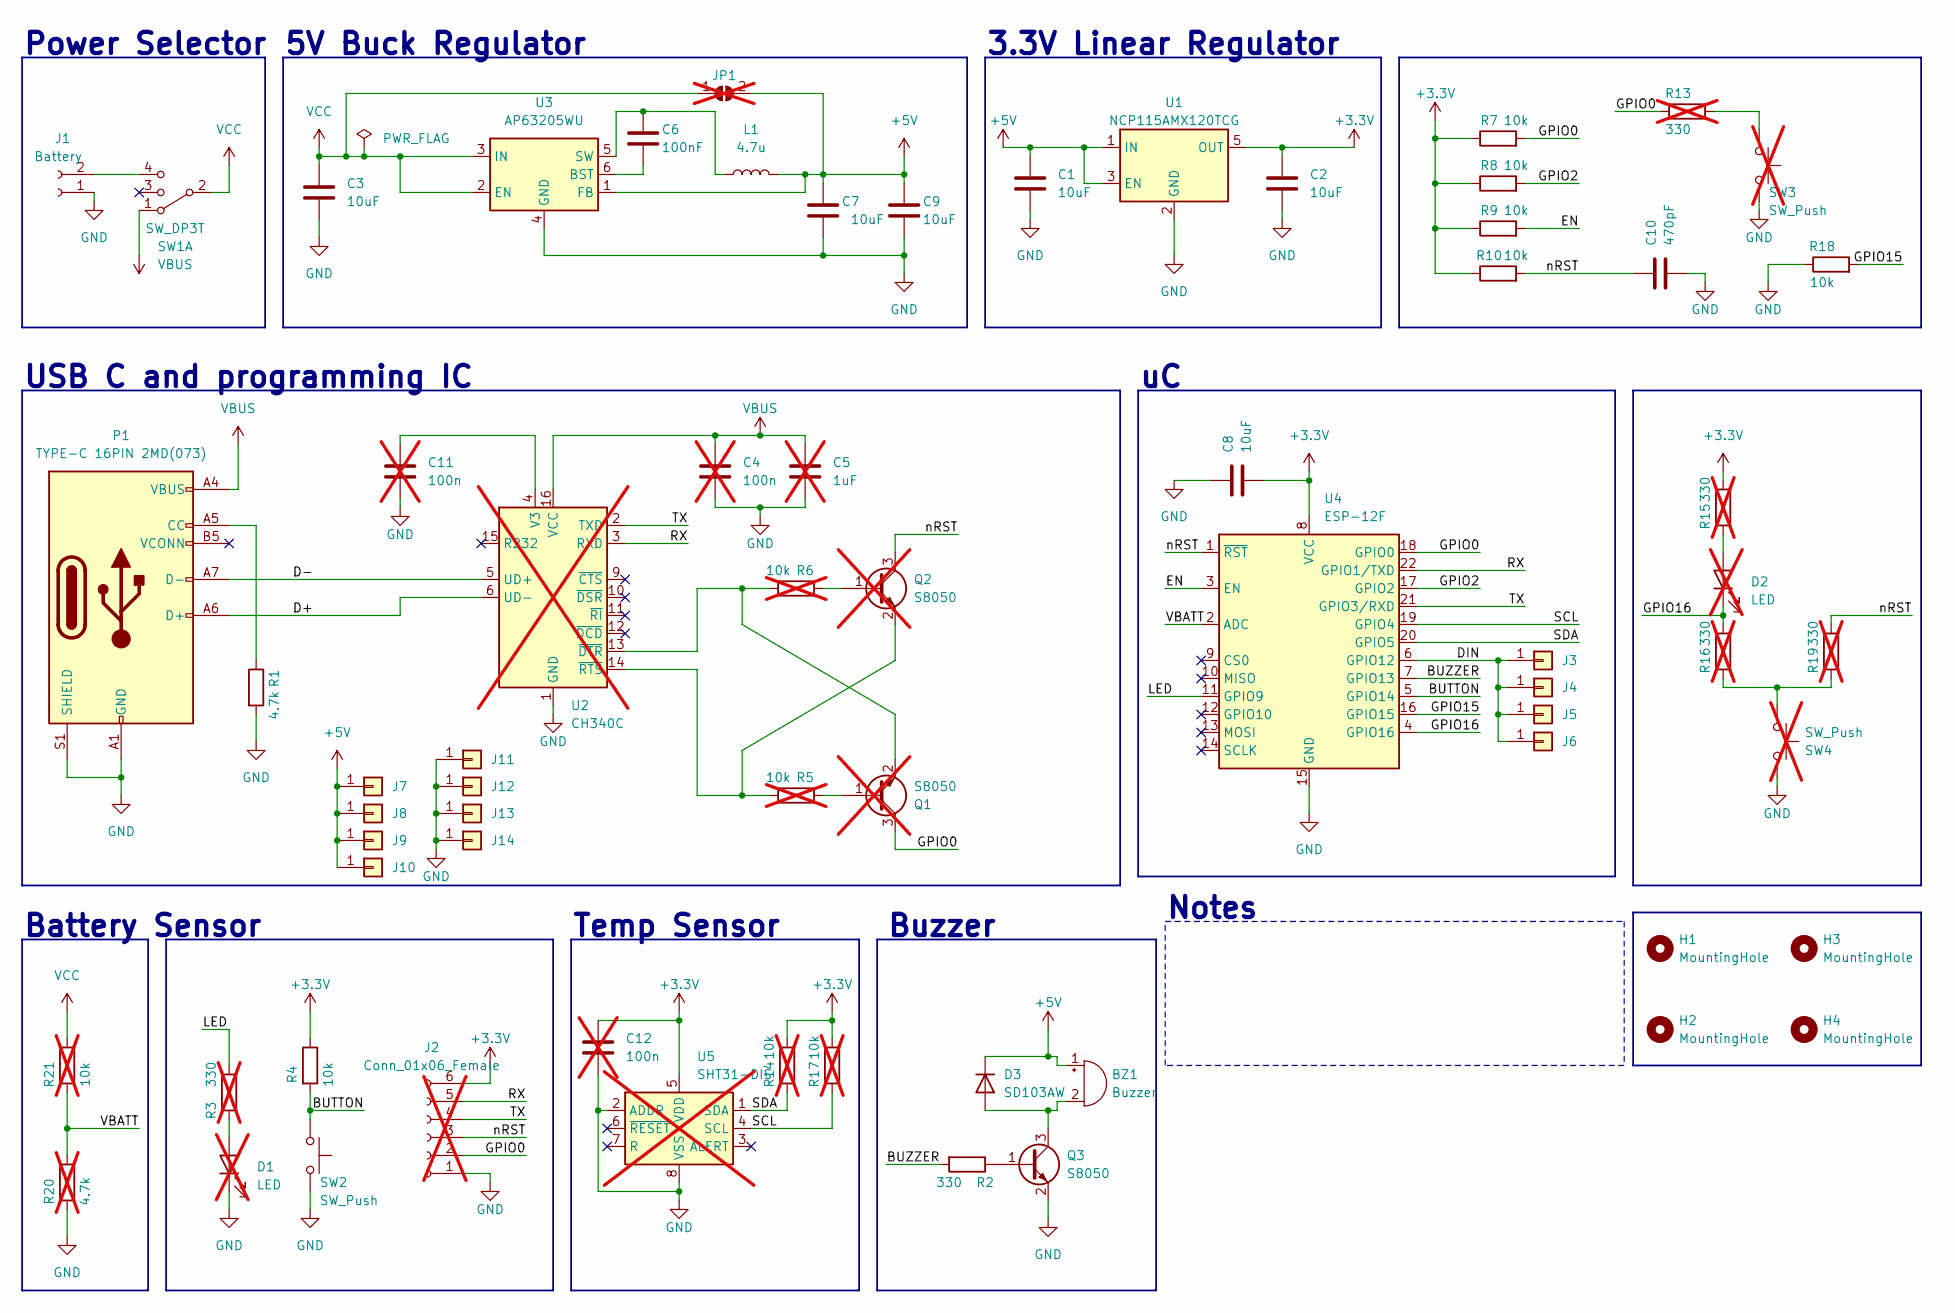
[picture p56: schematic Arbolito.kicad_sch, Arbolito Navideño]

Parts:
BZ1: Buzzer
C1, C2, C3, C7, C8, C9: 10uF; C_0805_2012Metric
C4, C11, C12: 100n; C_0805_2012Metric; not fitted
C5: 1uF; C_0805_2012Metric; not fitted
C6: 100nF; C_0805_2012Metric
C10: 470pF; C_0805_2012Metric
D1, D2: LED; LED_0805_2012Metric; not fitted
D3: SD103AW; D_SOD-123
H1, H2, H3, H4: MountingHole; MountingHole_3.2mm_M3_ISO7380
J1: Battery
J2: Conn_01x06_Female; PinHeader_1x06_P2.54mm_Vertical; not fitted
J3, J4, J5, J6: Conn_01x01; Pad_tree_Data
J7, J8, J9, J10, J11, J12, J13, J14: Conn_01x01; Pad_tree_PS
JP1: SolderJumper_2_Open; SolderJumper-2_P1.3mm_Open_RoundedPad1.0x1.5mm; not fitted
L1: 4.7u; L_Taiyo-Yuden_MD-3030
P1: TYPE-C 16PIN 2MD(073)
Q1, Q2: S8050; SOT-23; not fitted
Q3: S8050; SOT-23
R1: 4.7k; R_0805_2012Metric_Pad1.20x1.40mm_HandSolder
R2: 330; R_0805_2012Metric_Pad1.20x1.40mm_HandSolder
R3, R13, R15, R16, R19: 330; R_0805_2012Metric_Pad1.20x1.40mm_HandSolder; not fitted
R4, R7, R8, R9, R10, R18: 10k; R_0805_2012Metric_Pad1.20x1.40mm_HandSolder
R5, R6, R14, R17, R21: 10k; R_0805_2012Metric_Pad1.20x1.40mm_HandSolder; not fitted
R20: 4.7k; R_0805_2012Metric_Pad1.20x1.40mm_HandSolder; not fitted
SW1: SW_DP3T; 3PSwitch_Cheap
SW2: SW_Push; Button
SW3, SW4: SW_Push; Button; not fitted
U1: NCP115AMX120TCG; SOT-23-5_HandSoldering
U2: CH340C; SOIC-16_3.9x9.9mm_P1.27mm; not fitted
U3: AP63205WU; TSOT-23-6
U4: ESP-12F; ESP-12E
U5: SHT31-DIS; Sensirion_DFN-8-1EP_2.5x2.5mm_P0.5mm_EP1.1x1.7mm; not fitted

Connections:
+5V: BZ1.1 (-), C1.1, C7.1, C9.1, D3.1 (K), J7.1, J8.1, J9.1, J10.1, JP1.2 (B), L1.2, U1.1 (IN), U1.3 (EN), U3.1 (FB)
/BUTTON: R4.2, SW2.1, U4.5 (GPIO14)
/BUZZER: R2.2, U4.7 (GPIO13)
/D+: P1.A6 (D+), U2.6 (UD-)
/D-: P1.A7 (D-), U2.5 (UD+)
/DIN: J3.1, J4.1, J5.1, J6.1, U4.6 (GPIO12)
/EN: R9.2, U4.3 (EN)
/GPIO0: J2.2, Q1.3 (C), R7.2, R13.2, U4.18 (GPIO0)
/GPIO2: R8.2, U4.17 (GPIO2)
/GPIO15: R18.2, U4.16 (GPIO15)
/GPIO16: D2.1 (K), R16.2, U4.4 (GPIO16)
/LED: R3.2, U4.11 (GPIO9)
/RX: J2.5, U2.3 (RXD), U4.22 (GPIO1/TXD)
/SCL: R17.1, U4.19 (GPIO4), U5.4 (SCL)
/SDA: R14.1, U4.20 (GPIO5), U5.1 (SDA)
/TX: J2.4, U2.2 (TXD), U4.21 (GPIO3/RXD)
/VBATT: R20.1, R21.2, U4.2 (ADC)
/nRST: C10.1, J2.3, Q2.3 (C), R10.2, R19.2, U4.1 (~RST)
unnamed: BZ1.2 (+), D3.2 (A), Q3.3 (C)
unnamed: D1.2 (A), R3.1
unnamed: D2.2 (A), R15.1
unnamed: J1.2, SW1.4
unnamed: P1.A5 (CC), R1.1
unnamed: Q1.1 (B), R5.1
unnamed: Q1.2 (E), R6.2, U2.13 (~DTR)
unnamed: Q2.1 (B), R6.1
unnamed: Q2.2 (E), R5.2, U2.14 (~RTS)
unnamed: Q3.1 (B), R2.1
unnamed: R13.1, SW3.1
unnamed: R16.1, R19.1, SW4.1
unnamed: C11.1, U2.4 (V3)
unnamed: C6.2, U3.6 (BST)
unnamed: C6.1, L1.1, U3.5 (SW)
VBUS: C4.1, C5.1, P1.A4 (VBUS), P1.A9 (VBUS), P1.B4 (VBUS), P1.B9 (VBUS), SW1.1, U2.16 (VCC)
VCC: C3.1, JP1.1 (A), R21.1, SW1.2 (1), U3.2 (EN), U3.3 (IN)

Notes on the sheet:
Power Selector
Temp Sensor
Buzzer
USB C and programming IC
3.3V Linear Regulator
Battery Sensor
5V Buck Regulator
Notes

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
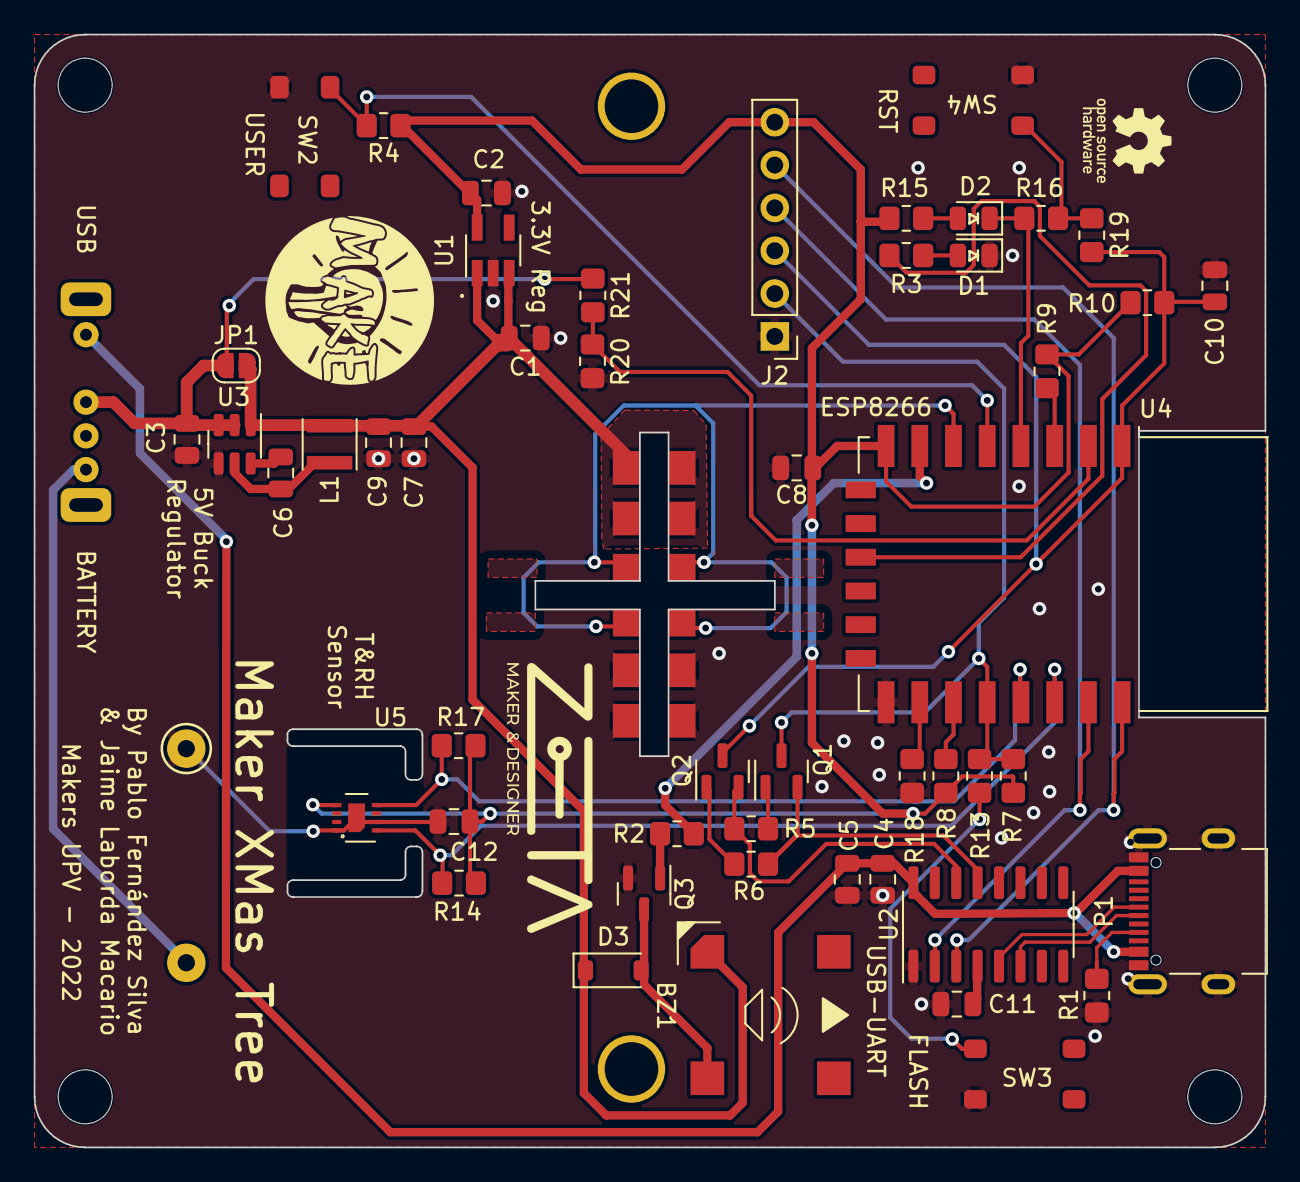
[picture p57: board Arbolito.kicad_pcb from above]

Board: 2 copper layers, 73.0 x 66.0 mm, 68 parts (1 on the bottom side), 37 nets.
