makers-upv/maker-xmas-tree/pcb/kicad/Tronco 1/Arbolito Tronco.kicad_pcb

## KiCad design pcb/kicad/Tronco 1/Arbolito Tronco.kicad_pcb (2023-12-17)

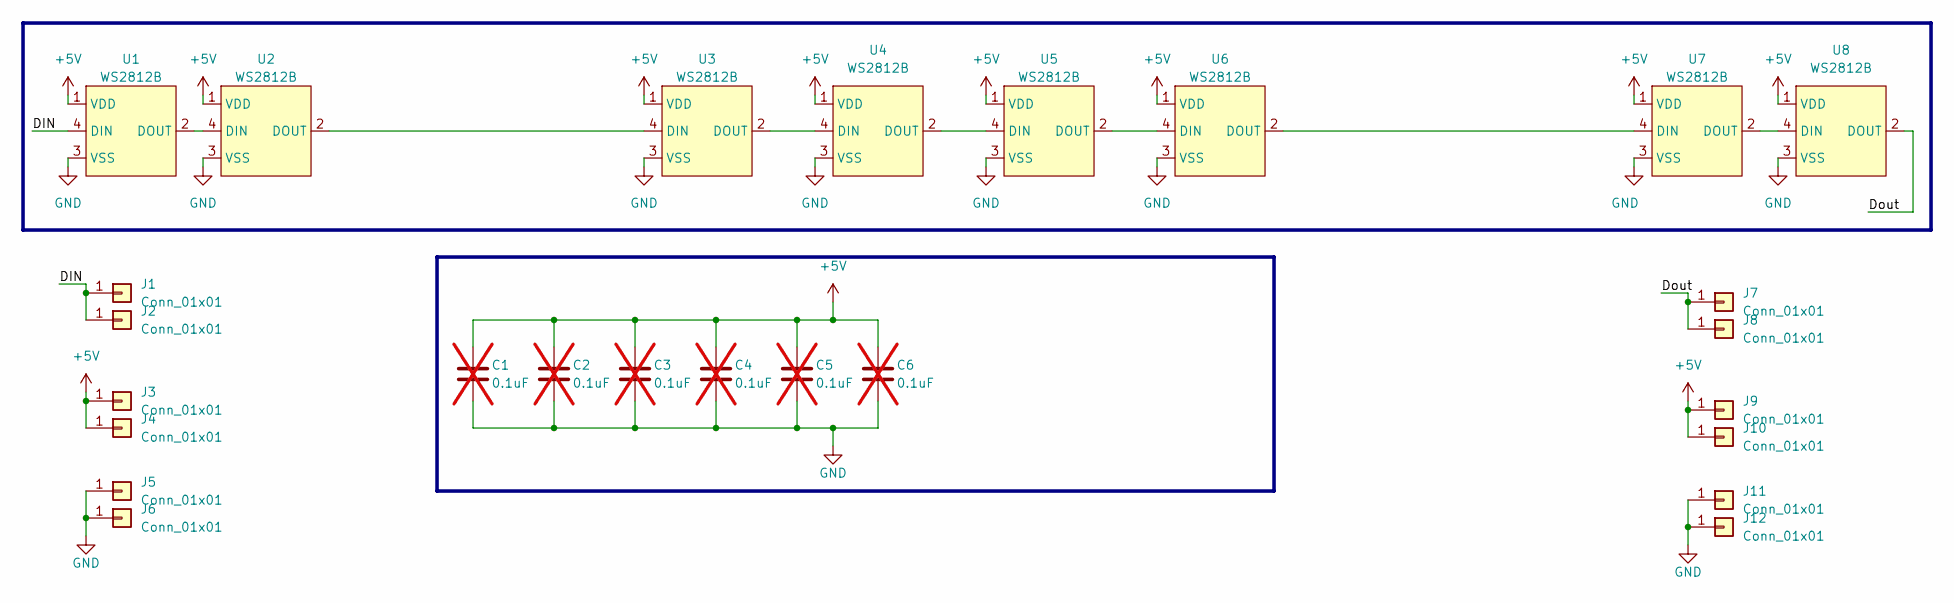
[picture p58: schematic Arbolito Tronco.kicad_sch]

Parts:
C1, C2, C3, C4, C5, C6: 0.1uF; C_0805_2012Metric; not fitted
J1, J2, J3, J4, J5, J6: Conn_01x01; Input
J7, J8, J9, J10, J11, J12: Conn_01x01; Output
U1, U2, U3, U4, U5, U6, U7, U8: WS2812B; LED_WS2812B_PLCC4_5.0x5.0mm_P3.2mm

Connections:
+5V: C1.1, C2.1, C3.1, C4.1, C5.1, C6.1, J3.1, J4.1, J9.1, J10.1, U1.1 (VDD), U2.1 (VDD), U3.1 (VDD), U4.1 (VDD), U5.1 (VDD), U6.1 (VDD), U7.1 (VDD), U8.1 (VDD)
/DIN: J1.1, J2.1, U1.4 (DIN)
/Dout: J7.1, J8.1, U8.2 (DOUT)
GND: C1.2, C2.2, C3.2, C4.2, C5.2, C6.2, J5.1, J6.1, J11.1, J12.1, U1.3 (VSS), U2.3 (VSS), U3.3 (VSS), U4.3 (VSS), U5.3 (VSS), U6.3 (VSS), U7.3 (VSS), U8.3 (VSS)
unnamed: U1.2 (DOUT), U2.4 (DIN)
unnamed: U2.2 (DOUT), U3.4 (DIN)
unnamed: U3.2 (DOUT), U4.4 (DIN)
unnamed: U4.2 (DOUT), U5.4 (DIN)
unnamed: U5.2 (DOUT), U6.4 (DIN)
unnamed: U6.2 (DOUT), U7.4 (DIN)
unnamed: U7.2 (DOUT), U8.4 (DIN)

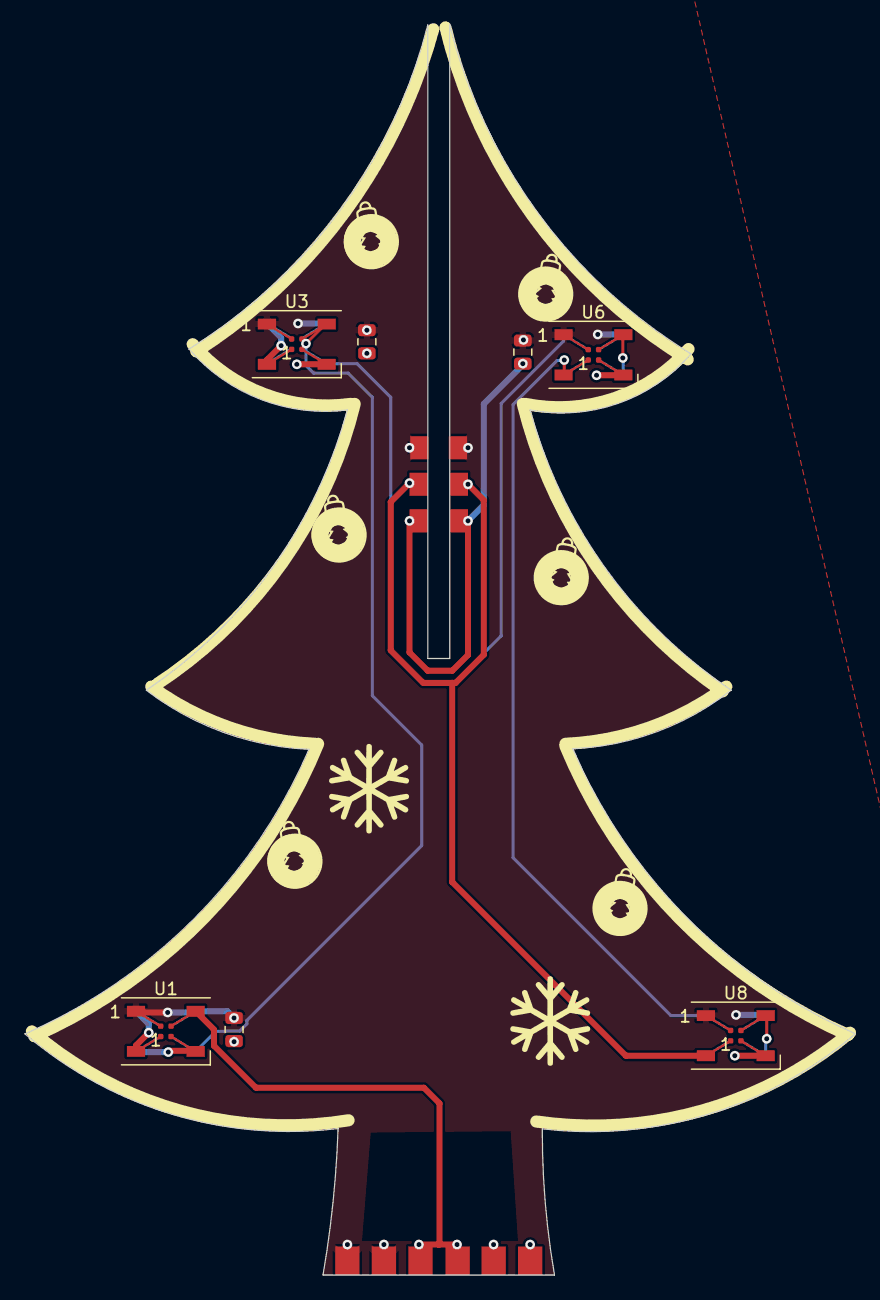
[picture p59: board Arbolito Tronco.kicad_pcb from above]

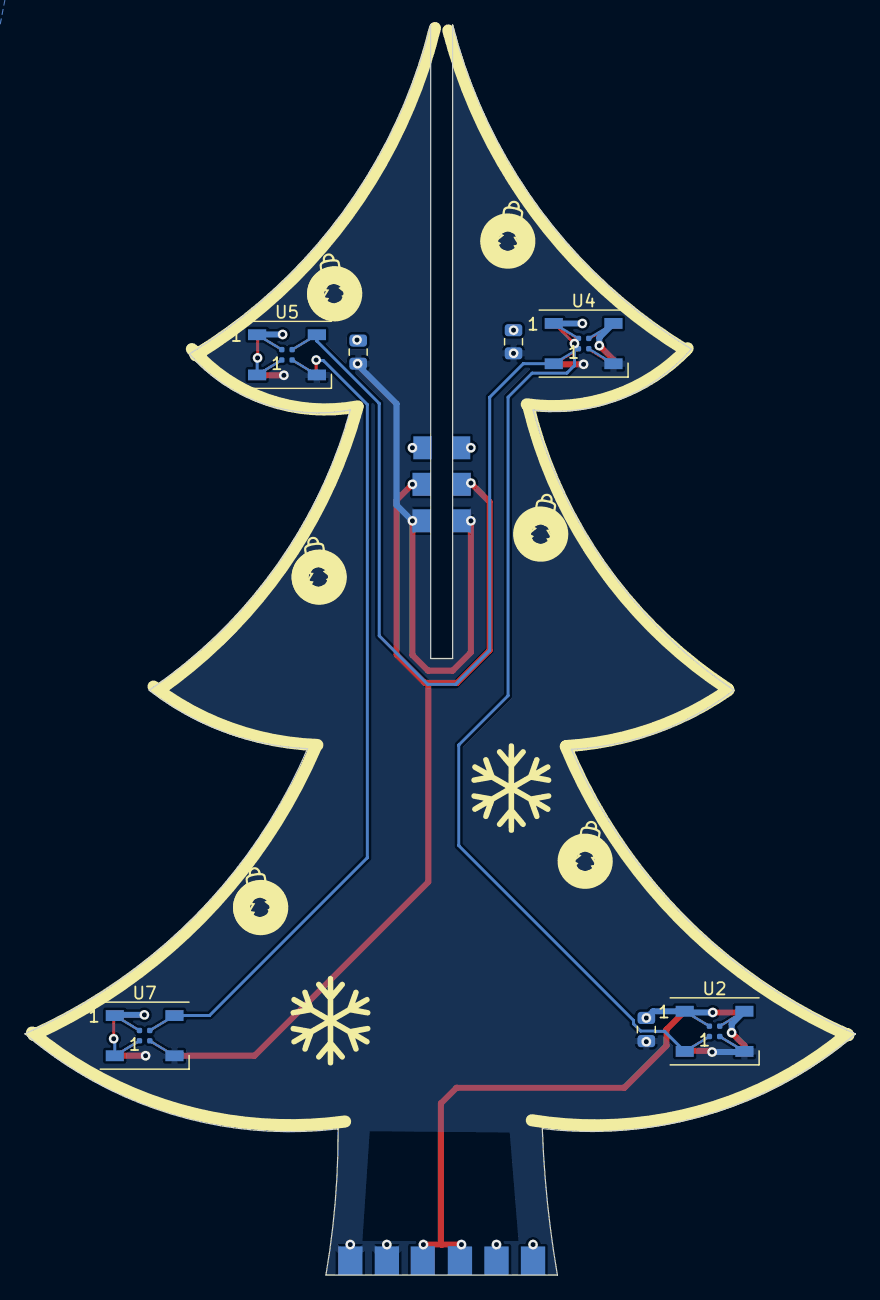
[picture p60: board Arbolito Tronco.kicad_pcb from below]

Board: 2 copper layers, 68.2 x 102.6 mm, 26 parts (7 on the bottom side), 11 nets.
