makers-upv/maker-xmas-tree/(commit log)

2022-12-11 Added PCB kicad source code and documentation
    [Arbolito Tronco 2.kicad_pcb, Arbolito Tronco 2.kicad_sch, Arbolito Tronco.kicad_pcb, Arbolito Tronco.kicad_sch, Arbolito.kicad_pcb, Arbolito.kicad_sch]
2022-12-11 Added example index.html to test web for redirect to interactive bom
2022-12-11 Added Interactive BOM files to the web
2022-12-15 Change R20 with 1K resistor
    [Arbolito.kicad_pcb, Arbolito.kicad_sch]
2023-10-28 CH340 VERSION
    [10_Arbolito-F_Silkscreen.gto, 12_Arbolito-NPTH.drl, 13_Arbolito-PTH.drl, 15_Arbolito Tronco-B_Cu.gbl, 16_Arbolito Tronco-B_Mask.gbs, 17_Arbolito Tronco-B_Paste.gbp, 18_Arbolito Tronco-B_Silkscreen.gbo, 1_Arbolito-B_Cu.gbl]
2023-11-01 New_Footprints
    3PSwitch and button footprints added to library. (not yet to PCB)
2023-11-01 SHT31 addition
    SHT11 Temp sensor changed to SHT31. Furthermore isolation slots where included
    [Arbolito.kicad_pcb]
2023-11-03 Switch and buttons
    Switch and buttons changed on PCB
    [Arbolito.kicad_pcb, Arbolito.kicad_sch]
2023-11-03 Switchs Corrected
    [Arbolito.kicad_pcb]
2023-11-09 Few leds version added
    [Arbolito Tronco 2-B_Cu.gbl, Arbolito Tronco 2-B_Mask.gbs, Arbolito Tronco 2-B_Paste.gbp, Arbolito Tronco 2-B_Silkscreen.gbo, Arbolito Tronco 2-Edge_Cuts.gko, Arbolito Tronco 2-Edge_Cuts.gm1, Arbolito Tronco 2-F_Cu.gtl, Arbolito Tronco 2-F_Mask.gts]
2023-11-10 Footprints corrected
    [Arbolito Tronco 2.kicad_pcb, Arbolito Tronco 2.kicad_sch, Arbolito Tronco.kicad_pcb, Arbolito Tronco.kicad_sch, Arbolito.kicad_pcb, Arbolito.kicad_sch]
2023-11-11 Modified USB C Molex 2169900002 footprint and added 3D step
    [Arbolito.kicad_pcb]
2023-11-12 BatteryHolder on place :3
    [Arbolito.kicad_pcb]
2023-11-12 Data lines fixed
    [Arbolito.kicad_pcb]
2023-11-12 Pre USB change
    [Arbolito Tronco.kicad_pcb, Arbolito Tronco.kicad_sch]
2023-11-12 Led Footprint Changed
    [2PCB.step, Arbolito Tronco 2.kicad_pcb, Arbolito Tronco 2.kicad_sch, Arbolito Tronco 2.step, Arbolito Tronco.kicad_pcb, Arbolito Tronco.step]
2023-11-12 Modified USB-C with 3 cents version
    [Arbolito.kicad_pcb, Arbolito.kicad_sch]
2023-12-16 Do some cleaning and add .gitignore
    [2PCB.step, Arbolito Tronco 1.step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]
2023-12-17 Added Rev3 release files
    - Added ibom html files
    - Update ibom in .web directory
    - Update pdf schematics
    - Added 3D steps files
    - Added tools for help to mount the PCB
    - Added hw rev3 gerber files
    [Arbolito Tronco 2.kicad_pcb, Arbolito Tronco 2.kicad_sch, Arbolito Tronco.kicad_pcb, Arbolito Tronco.kicad_sch, Arbolito.kicad_pcb, Arbolito.kicad_sch, Maker XMas Tree Joint Tool.SLDPRT, Maker XMas Tree Joint Tool.STEP]
2023-12-20 Modify ibom html and added WLED binary files
    [Arbolito.kicad_pcb, Arbolito.kicad_sch]
